CoAuToSe/Robocup-SSL-Aquitaine/SSL Senior (Small Size League)/Robot_SSL_v1_NAMeC/Electronique/brushless/brushless_parts.xlsx

Farnell | Name | Value | Device | Package | Link
721980 | C17 | 15pF | C_EU_22PF | C0603 | https://fr.farnell.com/yageo/cc0603jrnpo9bn150/cond-15pf-50v-5-c0g-np0-0603/dp/721980?ost=721980
 | C18 | 15pF | C_EU_22PF | C0603
1022248 | GND | CONNEC_1X03 | CONNEC_1X03 | CONNEC_1X03 | https://fr.farnell.com/harwin/m20-9990345/header-droit-2-54mm-1-rangee-3/dp/1022248?ost=1022248
 | V+ | CONNEC_1X03 | CONNEC_1X03 | CONNEC_1X03
1022256 | LOGIC | CONNEC_1X08 | CONNEC_1X08 | CONNEC_1X08 | https://fr.farnell.com/harwin/m20-9990845/embase-1-rangee-8-voies/dp/1022256?ost=1022256
1144713 | C10 | 100uF | CPOL_EU_3.5-8 | E3,5-8 | https://fr.farnell.com/rubycon/50zl100mefc8x11-5/condensateur-100-f-50v-20/dp/1144713?ost=1144713
1329624 | SENSE | ACS712 | ACS712 | SO8 | https://fr.farnell.com/allegro-microsystems/acs712elctr-20a-t/capteur-current-20a-soic8-712/dp/1329624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
1414620 | C20 | 18pF | CAP0805 | 0805@1 | https://fr.farnell.com/kemet/c0603c180j5gactu/cond-18pf-50v-5-c0g-np0-0603/dp/1414620?ost=1414620
 | C21 | 18pF | CAP0805 | 0805@1
1437637 | BUT | KMR211GLFS | BUTTON-KMR241GLFS | PUSHBUTTON-KMR241GLFS | https://fr.farnell.com/c-k-components/kmr241g-lfs/tactile-commutateur-cms-4n/dp/1437637?ost=1437637
 | RESET | KMR211GLFS | BUTTON-KMR241GLFS | PUSHBUTTON-KMR241GLFS
1581233 | D4 | Blue | LED1206 | LED-1206 | https://fr.farnell.com/multicomp/mcl-s250sblc/led-cms-1206-super-bleu/dp/1581233?ost=1581233
1606327 | UC1 | STM32F103CBT6 | STM32F103CB | LQFP48 | https://fr.farnell.com/stmicroelectronics/stm32f103cbt6/mcu-32bit-cortex-m3-72mhz-lqfp/dp/1606327?ost=1606327
1842013 | OSC1 | 40Mhz | CRYSTAL5X3 | CRYSTAL-SMD-5X3 | https://fr.farnell.com/txc/7b-40-000meeq-t/xtal-40-000mhz-10pf-smd-5-0x3/dp/1842013?ost=1842013
2296000 | DRV1 | OPEN-BLDC_IR2101 | OPEN-BLDC_IR2101 | OPEN-BLDC_SO-8 | https://fr.farnell.com/infineon/ir2101strpbf/driver-de-mosfet-high-low-side/dp/2296000?ost=2296000
 | DRV2 | OPEN-BLDC_IR2101 | OPEN-BLDC_IR2101 | OPEN-BLDC_SO-8
 | DRV3 | OPEN-BLDC_IR2101 | OPEN-BLDC_IR2101 | OPEN-BLDC_SO-8
2317446 | D1 | (empty) | ZETEX_VAR2SOT23 | ZETEX_SOT-23 | https://fr.farnell.com/on-semiconductor/bas21lt3g/diode-faible-signal-250v-sot-23/dp/2317446?ost=2317446
 | D2 | (empty) | ZETEX_VAR2SOT23 | ZETEX_SOT-23
 | D3 | (empty) | ZETEX_VAR2SOT23 | ZETEX_SOT-23
2319916 | Q1 | BUK7Y12-40E | BUK7Y12-40E | SOT669 | https://fr.farnell.com/nexperia/buk7y12-40ex/mosfet-n-ch-40v-52a-lfpak/dp/2319916?ost=2319916
 | Q2 | BUK7Y12-40E | BUK7Y12-40E | SOT669
 | Q3 | BUK7Y12-40E | BUK7Y12-40E | SOT669
 | Q4 | BUK7Y12-40E | BUK7Y12-40E | SOT669
 | Q5 | BUK7Y12-40E | BUK7Y12-40E | SOT669
 | Q6 | BUK7Y12-40E | BUK7Y12-40E | SOT669
2446904 | R1 | 1K | RESISTOR0805 | 805 | https://fr.farnell.com/multicomp/mcwr08x1001ftl/res-couche-epaisse-1k-1-0-125w/dp/2446904?st=2446904
 | R2 | 1K | RESISTOR0805 | 805
 | R3 | 1K | RESISTOR0805 | 805
 | R36 | 1K | RESISTOR0805 | 805
 | R39 | 1K | RESISTOR0805 | 805
 | R4 | 1K | RESISTOR0805 | 805
 | R49 | 1K | RESISTOR0805 | 805
 | R5 | 1K | RESISTOR0805 | 805
 | R6 | 1K | RESISTOR0805 | 805
2446909 | R28 | 1.5K | RESISTOR0805 | 805 | https://fr.farnell.com/multicomp/mcwr08x1501ftl/res-couche-epaisse-1-5k-1-0-125w/dp/2446909?st=2446909
2446926 | R29 | 22 | RESISTOR0805 | 805 | https://fr.farnell.com/multicomp/mcwr08x22r0ftl/res-couche-epaisse-22r-1-0-125w/dp/2446926?st=2446926
 | R35 | 22 | RESISTOR0805 | 805
2446939 | R20 | 2K | RESISTOR0805 | 805 | https://fr.farnell.com/multicomp/mcwr08x2001ftl/res-couche-epaisse-2k-1-0-125w/dp/2446939?st=2446939
2446965 | R21 | 3K | RESISTOR0805 | 805 | https://fr.farnell.com/multicomp/mcwr08x3001ftl/res-couche-epaisse-3k-1-0-125w/dp/2446965?st=2446965
2447553 | R10 | 10K | RESISTOR0805 | 805 | https://fr.farnell.com/multicomp/mcwr08x1002ftl/res-couche-epaisse-10k-1-0-125w/dp/2447553?ost=2447553
 | R11 | 10K | RESISTOR0805 | 805
 | R12 | 10K | RESISTOR0805 | 805
 | R14 | 10K | RESISTOR0805 | 805
 | R15 | 10K | RESISTOR0805 | 805
 | R16 | 10K | RESISTOR0805 | 805
 | R17 | 10K | RESISTOR0805 | 805
 | R18 | 10K | RESISTOR0805 | 805
 | R19 | 10K | RESISTOR0805 | 805
 | R23 | 10K | RESISTOR0805 | 805
 | R24 | 10K | RESISTOR0805 | 805
 | R25 | 10K | RESISTOR0805 | 805
 | R40 | 10K | RESISTOR0805 | 805
 | R48 | 10K | RESISTOR0805 | 805
 | R50 | 10K | RESISTOR0805 | 805
 | R7 | 10K | RESISTOR0805 | 805
 | R8 | 10K | RESISTOR0805 | 805
 | R9 | 10K | RESISTOR0805 | 805
2467818 | OSC | 8MHz | CRYSTAL5X3 | CRYSTAL-SMD-5X3 | https://fr.farnell.com/abracon/abm3b-8-000mhz-b2-t/crystal-8mhz-18pf-5-x-3-2mm/dp/2467818?ost=2467818
2470830 | K1 | (empty) | 614105150721 | 614105150721 | https://fr.farnell.com/wurth-elektronik/614105150721/embase-micro-usb-2-0-type-b-traversant/dp/2470830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
2496935 | C4 | 1000pF | CAP0805 | 0805@1 | https://fr.farnell.com/walsin/0805b102k500ct/cond-1000pf-50v-10-x7r-0805/dp/2496935?ost=2496935
2496946 | C12 | 1uF | CAP0805 | 0805@1 | https://fr.farnell.com/walsin/0805b105k160ct/condensateur-1-f-16v-10-x7r-0805/dp/2496946?ost=2496946
 | C7 | 1uF | CAP0805 | 0805@1
2528772 | C1 | 10µF | 0.33UF/330NF-0805-50V-10% | 805 | https://fr.farnell.com/tdk/c2012x5r1v106k085ac/condensateur-10-f-35v-10-x5r-0805/dp/2528772?ost=2528772
 | C2 | 10µF | 0.33UF/330NF-0805-50V-10% | 805
 | C3 | 10µF | 0.33UF/330NF-0805-50V-10% | 805
7261403 | REG1 | TS2940CW-3.3RP | TS2940CW-3.3RP | SOT223 | https://fr.farnell.com/taiwan-semiconductor/ts2940cw-3-3-rp/regulateur-cms-3-3v/dp/7261403?ost=7261403
- | ENC1 | LS7366RSO14 | LS7366RSO14 | SO14
 | JP1 | JUMPER-SMT_2_NO_NO-SILK_ROUND | JUMPER-SMT_2_NO_NO-SILK_ROUND | SMT-JUMPER_2_NO_NO-SILK_ROUND
 | JP2 | JUMPER-SMT_2_NO_NO-SILK_ROUND | JUMPER-SMT_2_NO_NO-SILK_ROUND | SMT-JUMPER_2_NO_NO-SILK_ROUND
 | X1 | JST-XH-10-PIN-LONG-PAD | JST-XH-10-PIN-LONG-PAD | JST-XH-10-PACKAGE-LONG-PAD
8737843RL | D5 | (empty) | DIODESOD | SOD-323 | https://fr.farnell.com/nexperia/pmeg2005aea-115/diode-schottky-boitier-sod-323/dp/8737843RL?ost=8737843rl
Total Result
 |  | jumper : cavalier
 |  | s
 |  | attention soudure : composants pas tous traversants : CMS (il faut obligatoirement une station à air chaud)
 |  | achat poste à air chaud
