CoAuToSe/Robocup-SSL-Aquitaine/SSL Senior (Small Size League)/Robot_SSL_v1_NAMeC/Electronique/kicker/kicker_parts.xlsx

Farnell | Name | Value | Device | Package | Links
1738824 | R5 | 10 | RESISTANCE-R0805 | R0805 | https://fr.farnell.com/vishay/crcw040210r0fkedhp/res-10r-1-0-2w-0402-couche-epaisse/dp/1738824?st=cms%2010ohm
 | R6 | 10 | RESISTANCE-R0805 | R0805
1469932 | R1 | 470 | RESISTANCE-R0805 | R0805 | https://fr.farnell.com/vishay/crcw0805470rfkea/res-couche-epaisse-470r-1-0-125w/dp/1469932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
 | R2 | 470 | RESISTANCE-R0805 | R0805
 | R4 | 470 | RESISTANCE-R0805 | R0805
 | R7 | 470 | RESISTANCE-R0805 | R0805
1738877 | R10 | 100K | RESISTANCE-R0805 | R0805 | https://fr.farnell.com/vishay/crcw0402100kfkedhp/res-100k-1-0-2w-0402-couche-epaisse/dp/1738877?st=100k%20cms
 | R11 | 100K | RESISTANCE-R0805 | R0805
 | R8 | 100K | RESISTANCE-R0805 | R0805
2447553 | R9 | 10K | RESISTANCE-R0805 | R0805 | https://fr.farnell.com/multicomp/mcwr08x1002ftl/res-couche-epaisse-10k-1-0-125w/dp/2447553?ost=2447553
 | R35 | 10K | RESISTANCE-R0805 | R0805
2319144 | D5 | 12V | ZENER-DIODESOD80C | SOD80C | https://fr.farnell.com/nexperia/bzv55-b12-115/diode-zener-12v-500mw-sod-80c/dp/2319144?ost=2319144
1469746 | R3 | 1M | RESISTANCE-R0805 | R0805 | https://fr.farnell.com/vishay/crcw06031m00fkea/res-couche-epaisse-1m-1-0-1w-0603/dp/1469746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
 | R34 | 1M | RESISTANCE-R0805 | R0805
9551735 | D2 | 1N6267A | 1N6267A | C4111-15 | https://fr.farnell.com/vishay/uf5408-e3-54/diode-de-redressement-rapide-3a/dp/9551735?ost=9551735
 | D3 | 1N6267A | 1N6267A | C4111-15
1637035RL | C1 | 1uF | C-EUC0805 | C0805 | https://fr.farnell.com/kemet/c0805c105k3ractu/condensateur-1-f-25v-10-x7r-0805/dp/1637035RL?st=c0805%201u
 | C2 | 1uF | C-EUC0805 | C0805
1097198 | D1 | 3.9V | ZENER-DIODESOD80C | SOD80C | https://fr.farnell.com/nexperia/bzv55-c3v9-115/diode-zener-500mw-3-9v/dp/1097198?ost=1097198
2446965 | R36 | 3K | RESISTANCE-R0805 | R0805 | https://fr.farnell.com/multicomp/mcwr08x3001ftl/res-couche-epaisse-3k-1-0-125w/dp/2446965?st=2446965
- | U$5 | BOOSTER | BOOSTER | BOOSTER_390V | https://fr.banggood.com/DC-DC-45-390V-Adjustable-High-Voltage-Booster-Regulator-Capacitor-Charging-Electromagnetic-Power-Module-p-1598959.html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
2251951 | Q1 | BSS123 | BSS123 | SOT23 | https://fr.farnell.com/on-semiconductor/bss123/mosfet-n-ch-100v-170ma-sot-23/dp/2251951?st=bss123
 | Q2 | BSS123 | BSS123 | SOT23
- | BOOST_EN | CONNEC_1X01 | CONNEC_1X01 | CONNEC_1X01 | -
 | POWERCAP1 | CONNEC_1X02BIG | CONNEC_1X02BIG | CONNEC_1X02_BIG | -
 | POWERCAP2 | CONNEC_1X02BIG | CONNEC_1X02BIG | CONNEC_1X02_BIG
- | SOLENOID1 | CONNEC_1X02BIG | CONNEC_1X02BIG | CONNEC_1X02_BIG | -
 | SOLENOID2 | CONNEC_1X02BIG | CONNEC_1X02BIG | CONNEC_1X02_BIG
1516283 | X2 | JST-XH-07-PIN-LONG-PAD | JST-XH-07-PIN-LONG-PAD | JST-XH-07-PACKAGE-LONG-PAD | https://fr.farnell.com/jst-japan-solderless-terminals/b7b-xh-a-lf-sn/embase-male-vertical-7-voies/dp/1516283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
1081223 | U$15 | NPN_BC817 | 215 | NPN_BC817 | https://fr.farnell.com/nexperia/bc817-215/transistor-npn-boitier-sot-23/dp/1081223?ost=1081223
8638730 | DRV1 | OPEN-BLDC_IR2101 | OPEN-BLDC_IR2101 | OPEN-BLDC_SO-8 | https://fr.farnell.com/infineon/ir2103spbf/driver-de-mosfet-igbt-cms-demi/dp/8638730?ost=8638730
 | DRV2 | OPEN-BLDC_IR2101 | OPEN-BLDC_IR2101 | OPEN-BLDC_SO-8
1581229 | D4 | RED | LED1206 | LED-1206 | https://fr.farnell.com/multicomp/mcl-s250src/led-cms-1206-super-rouge/dp/1581229?st=led1206
2610670 | U$1 | TO-247A | TO-247A | TO-247 | https://fr.farnell.com/on-semiconductor/fgh12040wd-f155/igbt-simple-canal-n-1-2kv-80a/dp/2610670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
 | U$11 | TO-247A | TO-247A | TO-247
