CoAuToSe/Robocup-SSL-Aquitaine/SSL Senior (Small Size League)/X-Proto 1/Liste_Banc_de_Test.xlsx

Liste Matériel
Nom de la piece | Utilité | Quantité dans l'article | Nombre à acheter | Prix Unitaire (€) | Prix Total (€) | Liens achat | Images
Roulement à bille (diamètre intérieur 3mm, extérieur 10mm) | Maintenir la barre du dribbleur durant le test | 1 | 2 | 3.61 | 7.22 | https://fr.rs-online.com/web/p/roulements-a-billes/8937420/
Cadre bois | Diminuer les vibrations | 1 | 0 | 13.5 | 0 | https://www.leroymerlin.fr/v3/p/produits/lot-de-6-tasseaux-sapin-petits-noeuds-brut-25-x-38-mm-l-2-4-m-e62031
Planche en bois | Soutenir le banc de test | 1 | 1 | 17.9 | 17.9 | https://www.leroymerlin.fr/produits/menuiserie/panneau-bois-tablette-etagere-tasseau-moulure-et-plinthe/panneau-bois-agglomere-mdf/panneau-bois-predecoupe/pre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
Scotch-Mousse | Diminuer les vibrations entre le banc de test et le Bati | 1 | 1 | 5.39 | 5.39 | https://fr.rs-online.com/web/p/rubans-mousse/0554866/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
Coupleur d'arbre d'accouplement (arbre 3mm de diamètre) | Coupler la dremmel et le dribbleur sans frottement | 1 | 1 | 44.52 | 44.52 | https://fr.rs-online.com/web/p/accouplements/0814556/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
 |  |  |  | Total (€) | 75.03
