CoAuToSe/Robocup-SSL-Aquitaine/SSL Senior (Small Size League)/Robot_SSL_v2/Liste_budget_SSLv2.xlsx

Sheet: Usinage
Composants à usiner
Nom | Nouveau nom | Description | Méthode d'usinage | Matériaux | Quantité | Commentaires | Images
01_Grundplatte | 01_Base plate | Plaque du bas | Milling | 7075 Aluminium Hight-Stength | 1
Mittleplatte | 02_Middle plate | Plaque Milieu | Milling | 7075 Aluminium Hight-Stength | 1
10_Lagerbock | 10_Motor leg | Socle moteur base | Milling | 7075 Aluminium Hight-Stength | 4
11_Radadapteur | 11_Wheel adapter | Adaptateur socle moteur roue | Milling | 7075 Aluminium Hight-Stength | 4
12_Radkasten | 12_Wheel inner | Roue intérieure | Milling | 7075 Aluminium Hight-Stength | 4
13_Raddeckel | 13_Wheel outher | Roue extérieure | Milling | 7075 Aluminium Hight-Stength | 4
14_Rolle | 14_Subwheel | Adaptateur roulement/X-Ring subwheels | Tournage | 7075 Aluminium Hight-Stength | 80
20_Dribbler Lagerbock | 20_Dribbler leg | Maintien rampe lob | Milling | 7075 Aluminium Hight-Stength | 2
21_Dribbler Seite | 21_Dribbler side | Coté dribbler | Milling | 7075 Aluminium Hight-Stength | 2
22_Dribbler Brueke | 22_Dribbler bridge | Plaque haut dribbler | Milling | 7075 Aluminium Hight-Stength | 1
23_Chip Schaufel | 23_Lob shovel | Rampe lob | Milling | 7075 Aluminium Hight-Stength | 1
24_Dribblingwelle | 24_Dribbling wheel | Axe dribbler | Tournage | 7075 Aluminium Hight-Stength | 1
25_Motorhalter | 25_Motor mount | Socle moteur dribbler | Milling | 7075 Aluminium Hight-Stength | 1
30_Kicker Eisen | 30_Kicker back | Partie Arrière des kickers | Milling | Ferromagnetic steel: St37 or C45 low carbon steel | 2
31_Kicker Sichel | 31_Kicker straight | Kicker droit partie avant | Milling | 7075 Aluminium Hight-Stength | 1
32_Kicker Chip | 32_Kicker lob | Kicker rampe-lob partie avant | Milling | 7075 Aluminium Hight-Stength | 1
33_Spulenhalter Hinten | 33_Spool holder at the back | Maintien arrière du kicker | Milling | 7075 Aluminium Hight-Stength | 1
34_Spulenhalter Vorne | 34_Spool holder in front | Maintien avant du kicker | Milling | 7075 Aluminium Hight-Stength | 1
35_maintien carte kicker | 35_maintien carte kicker | Maintien carte kicker | Milling | 7075 Aluminium Hight-Stength | 1

Sheet: Elec
Composants Electroniques
Nom / Référence | Description | Quantité | Spare (remplacement) | Commentaires | Prix Unitaire (€) | Prix total (€) | Liens achat | Images
Condensateur | Condensateurs cylindriques latéraux | 2 | 2 | 2200 µF - 200 V | 8.46 € | 33.84 € | https://uk.farnell.com/rubycon/200usg2200mefcsn35x40/cap-2200-f-200v-alu-elec-snap/dp/2102441 |  | 1800F-250V
4SLiPo | Batterie | 1 | 1 | 1800mAh Lipo - 22,2V | 30.86€ | 61.72 € | https://hobbyking.com/fr_fr/zippy-compact-1800mah-6s-40c-lipo-pack.html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
Maxon_EC45_70W | Moteur | 4 | 0 | Maxon_EC45_70W - 48V | 138.09€ | 552.36 € | https://www.maxongroup.fr/maxon/view/product/motor/ecmotor/ecflat/ecflat45/651620
MaxonECmax22-25W | Moteur dribbleur | 1 | 0 | MaxonECmax22-25W | 194.09 € | 194.09 € | https://www.maxongroup.fr/maxon/view/product/283856
Carte Mapple Mini simple | Cate servant à la programmation de tout le système embarqué | 1 | 3 |  | 6.90 € | 27.60 € | https://www.generationrobots.com/fr/403201-maple-mini.html
Kit Arduino (mapple mini) |  | 4 | 0 |  |  | 0.00 €
Module radio + Antennes radio 2.4GHz | 1100 Mètres Longue Distance NRF24L01+PA+LNA | 3 | 1 |  | 5.85 € | 23.40 € | https://www.banggood.com/fr/Geekcreit-1100-Meter-Long-Distance-NRF24L01+PA+LNA-Wireless-Module-With-Antenna-Module-p-1057170.html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
LED infrarouge + phototransistor | Barrière IR | lot | 0
Module infrarouge évitement obstacles | IR infrarouge evitement d'obstacle | 2 | 0 |  | 4.86 € | 9.72 € | https://fr.shopping.rakuten.com/offer/buy/2552519347/ir-infrarouge-evitement-d-39-obstacle-capteur-module-pour-arduino-voiture-smart-robot-fils-reflechissant-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 |  | impossible d'ouvrir le lien sous excel
Câbles normaux 2A, 24V | Câbles normaux supportant : 24V et 2A | lot | 0 | 24V ; 2A
Testeur de tension de batterie 1S-8S Lipo |  | 1 | 0 |  | 2.10 € | 2.10 € | https://fr.aliexpress.com/item/4000222359680.html?src=google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
Bobine de Cuivre | Fil de cuivre | 1 | 0 | 1.20mm,30 m de longueur | 20.89 € | 20.89 € | https://www.conrad.fr/p/fil-de-cuivre-tru-components-151501230-1562138-exterieur-sans-vernis-isolant-120-mm-30-m-1562138
Bobine de Cuivre | Fil de cuivre | 1 | 0 | 165m, 0.63mm, 0.5kg | 23.56 € | 23.56 € | https://www.conrad.de/de/p/block-kupferlackdraht-aussen-durchmesser-inkl-isolierlack-0-63-mm-165-m-0-50-kg-605523.html
 |  |  |  |  | Total (€) | 647.92 €

Sheet: Visserie
Composants Visserie
Nom / Référence | Quantité nécessaire | Description | Commentaires | Quantité dans l'article | Nombre à acheter (1 robot) | Prix Unitaire (€) | Prix Total (€) | Fournisseur liste Originale |  | Images
 |  |  |  |  |  |  |  | Fournisseur | N° Article
ISO 4762 - M2 x 6 | 15 | vis tete cylindrique M2 x 6 | ISO 4762 => DIN 912 | 50 | 1 | 2.74€ | 2.74€ | https://www.wegertseder.com/ArticleDetails.aspx?ANR=2534-234 | 2534-234
DIN 7984 - M3 x 5 | 32 | vis tete cylindrique M3 x 5 |  | 100 | 1 | 3.27€ | 3.27€ | https://www.wegertseder.com/ArticleDetails.aspx?ANR=2594-928 | 2594-928
DIN 7984 - M4 x 6 | 14 | vis tete cylindrique M4 x 6 |  | 50 | 1 | 2.99€ | 2.99€ | https://www.wegertseder.com/ArticleDetails.aspx?ANR=2594-954 | 2594-954
ISO 10642 - M3 x 6 | 22 | vis tete fraisée M3 x 6 |  | 100 | 1 | 3.24€ | 3.24€ | https://www.wegertseder.com/ArticleDetails.aspx?ANR=2608-680 | 2608-680
ISO 10642 - M3 x 8 | 34 | vis tete fraisée M3 x 8 |  | 100 | 1 | 3.28€ | 3.28€ | https://www.wegertseder.com/ArticleDetails.aspx?ANR=2608-682 | 2608-682
ISO 10642 - M4 x 8 | 8 | vis tete fraisée M4 x 8 |  | 100 | 1 | 3.47€ | 3.47€ | https://www.wegertseder.com/ArticleDetails.aspx?ANR=2608-708 | 2608-708
DIN 934 - M8 | 4 | Ecrou M8 |  | 10 | 1 | 2.61€ | 2.61€ | https://www.wegertseder.com/ArticleDetails.aspx?ANR=2914-422 | 2914-422
DIN 562 M3 | 4 | ecrou carré m3 |  | 100 | 1 | 3.86€ | 3.86€ | https://www.wegertseder.com/ArticleDetails.aspx?ANR=3198-486 | 3198-486
ISO - 4035 - M3 - C | 4 | Ecrou plat M3 | chez bafa pas 4035 | 100 | 1 | 2.89€ | 2.89€ | https://www.wegertseder.com/ArticleDetails.aspx?ANR=2996-111 | 2996-111
ISO 10642 - M3 x 16 | 4 | vis tete fraisée M3 x 16 |  | 100 | 1 | 3.00€ | 3.00€ | https://www.wegertseder.com/ArticleDetails.aspx?ANR=2608-690 | 2608-690
DIN 137 B8 | 4 | rondelle B 8mm |  | 100 | 1 | 4.16€ | 4.16€ | https://www.wegertseder.com/ArticleDetails.aspx?ANR=1738-294 | 1738-294
ISO 2338 - 2 m6 x 4 | 10 | Axe cylindrique 2mm x 4 |  | 200 | 1 | 5.38€ | 5.38€ | https://www.wegertseder.com/ArticleDetails.aspx?ANR=4347-136 | 4347-136
ISO 2338 - 2 m6 x 6 | 80 | Axe cylindrique 2mm x 6 | Forme pas totalement indentique | 200 | 1 | 5.09€ | 5.09€ | https://www.wegertseder.com/ArticleDetails.aspx?ANR=4347-140 | 4347-140
ISO 2338 - 2 m6 x 16 | 1 | Axe cylindrique 2mm x 16 | Forme pas totalement indentique | 200 | 1 | 7.50€ | 7.50€ | https://www.wegertseder.com/ArticleDetails.aspx?ANR=4347-150 | 4347-150
ISO 8745 4 x 10 | 4 | Goupille 4x10 |  | 20 | 1 | 6.35€ | 6.35€ | https://www.wegertseder.com/ArticleDetails.aspx?ANR=1028-042 | 1028-042
THERMAL PAD, 25.4X25.4MM, 1MM | 2 | Pad thermique |  | 1 | 2 | 3.31€ | 6.62€ | https://fr.farnell.com/wakefield-solutions/pl-1-5-254-h/thermal-pad-25-4x25-4mm-1mm/dp/2902536 | PL-1-5-254
Charge Marker | 1 | Indicateur batterie |  | 1 | 1 | 1.55€ | 1.55€ | https://www.stefansliposhop.de/en/accessories/charge-marker/charge-marker::1437.html | C-Marker
roullement 685-ZZ-C3 | 2 | Roulements à billes, disques de couverture des deux côtés, ID=5, AD=11, b=5 |  | 1 | 4 | 1.24€ | 4.96€ | https://www.kugellager-express.de/miniature-deep-groove-ball-bearing-685-zz-c3-5x11x5-mm | 685-ZZ-C3
roullement 692-ZZ | 2 | Roulements à billes, disques de couverture des deux côtés, ID=2, AD=6, b=3 |  | 1 | 4 | 2.40€ | 9.60€ | https://www.kugellager-express.de/stainless-steel-miniature-deep-groove-ball-bearing-ss-692-zz-2x6x3-mm | 692-ZZ
engrenage z20 | 1 | Roues en dents de front, laiton, module 0.5, z=20 (moteur) |  | 1 | 1 | 0 | 0 | https://www.michaud-chailly.fr/index.php?ent_id=1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 | 21102000
engrenage z20 | 1 | Roue en dents de front, laiton, module 0.5, z=20 | (axe l’engrenage est réusiné élargissement du trou) | 1 | 1 | 0 | 0 | https://www.michaud-chailly.fr/index.php?ent_id=1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 | 26102000
engrenage Polyketon z20 | 1 | Roue de l’extrémité, polycétone, module 0.5, z=20 |  | 1 | 1 | ? | #VALUE! | https://www.michaud-chailly.fr/index.php?ent_id=1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 | 28102001
X-Ring, 5.94x3.53 | 80 | X-Ring, 5.94x3.53mm, NBR, Shore A 70 |  | 1 | 85 | 0.18€ | 15.30€ | https://www.ir-dichtungstechnik.de/gewerbe/de/x-ring-5-94-x-3-53-mm-bs202-nbr-70-5-shore-a-schwarz-black.html | XRINGBS202NBR70
roulement MSM-0205-02 | 160 | Bague anti-frixtion MSM-0205-02 |  | 1 | 165 | 2.49€ | 410.85€ | https://www.igus.de/search?q=JSM-1012-05 | JSM-1012-05
ressort Z-015LI | 4 | Ressort de traction Z-015LI, Kickers |  | 1 | 5 | 2.77€ | 13.85€ | https://www.ferroflex.fr/fr/produits/ressorts_de_traction/z-015li.html | Z-015LI
ressort RZ-006DI | 2 | Ressort de traction RZ-006DI,Lober shovel |  | 1 | 3 | 2.83€ | 8.49€ | https://www.ferroflex.fr/fr/produits/ressorts_de_traction/rz-006di.html | RZ-006DI
Entretoise M4x60 | 4 | Entretoise Typ A, M4, 60mm |  | 100 | 1 | 38.10€ | 38.10€ | https://www.ettinger.de/p/kunststoff-abstandsbolzen-typ-a-i/i-m4/sw8x60-0-pa-gv-schwarz/005.30.460 | 5.30.460
Entretoise M4x70 | 3 | Entretoise Typ A, M4, 70mm |  | 100 | 1 | 34.20€ | 34.20€ | https://www.ettinger.de/p/abstandsbolzen-m3-typ-a/innen-innengewinde/005.03.701 | 005.03.701
Entretoise M3x63 | 5 | Entretoise Typ A, M3, 63mm |  | 100 | 1 | 39.60€ | 39.60€ | https://www.ettinger.de/p/kunststoff-abstandsbolzen-typ-a-i/i-m3/sw6x63-0-pa-gv-schwarz/005.30.363 | 005.30.363
Entretoise M3x25 | 12 | Entretoise Typ B, M3, 25mm |  | 100 | 1 | 24.50€ | 24.50€ | https://www.ettinger.de/p/kunststoff-abstandsbolzen-typ-b-i/a-m3x25-0-sw-6-pa-66-schwarz/005.43.250 | 005.43.250
Entretoise M3x25 | 4 | Entretoise Typ A, M3, 25mm |  | 100 | 1 | 27.40€ | 27.40€ | https://www.ettinger.de/p/kunststoff-abstandsbolzen-typ-a-i/i-m3/sw6x25-0-pa-gv-schwarz/005.30.325 | 005.30.325
Loctite | 1 | colle pour securiser le vis (egalement pr fixxer l'adaptateur roue / moteur au moteur) |  | 1 | 1 | 27.40€ | 27.40€ | https://de.rs-online.com/web/p/schraubensicherung-und-gewindesicherungsmittel/4767870/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 | 476-7870
Loctite 648 | 1 | colle pour securiser le vis (egalement pr fixxer l'adaptateur roue / moteur au moteur) |  | 1 | 1 | 59.28€ | 59.28€ | https://de.rs-online.com/web/p/sicherungsmittel/3731498/?searchHistory=%7B%22enabled%22%3Atrue%7D | 373-1498
 |  |  |  |  |  | Total | 781.53€

Sheet: Visserie BAFA
Composants Visserie
Nom / Référence | Quantité nécessaire | Description | Commentaires | Quantité dans l'article | Nombre à acheter (1 robot) | Prix Unitaire (€) | Prix Total (€) | Nouveaux Fournisseur (avec BAFA) |  | Images
 |  |  |  |  |  |  |  | Fournisseur | N° Article
ISO 4762 - M2 x 6 | 15 | vis tete cylindrique M2 x 6 | ISO 4762 => DIN 912 | 1 | 15 | 0.14€ | 2.10€ | https://shop.bafa-sa.com/vis-chc-din-912-m2x6-inox-a2-chi02006-15039.html | CHI02006
DIN 7984 - M3 x 5 | 32 | vis tete cylindrique M3 x 5 | Pas en x5 chez bafa donc en x6 | 1 | 34 | 0.14€ | 4.76€ | https://shop.bafa-sa.com/vis-chc-tete-basse-din-7984-m3x6-inox-a2-7984i03006-6755.html | 7984I03006
DIN 7984 - M4 x 6 | 14 | vis tete cylindrique M4 x 6 | non disponible chez bafa | 50 | 1 | 2.99€ | 2.99€ | https://www.wegertseder.com/ArticleDetails.aspx?ANR=2594-954 | 2594-954
ISO 10642 - M3 x 6 | 22 | vis tete fraisée M3 x 6 |  | 1 | 25 | 0.07€ | 1.75€ | https://shop.bafa-sa.com/vis-fhc-din-7991-m3x6-inox-a2-fhi03006-19906.html | FHI03006
ISO 10642 - M3 x 8 | 34 | vis tete fraisée M3 x 8 |  | 1 | 35 | 0.07€ | 2.45€ | https://shop.bafa-sa.com/vis-fhc-din-7991-m3x8-inox-a2-fhi03008-19907.html | FHI03008
ISO 10642 - M4 x 8 | 8 | vis tete fraisée M4 x 8 |  | 1 | 10 | 0.08€ | 0.80€ | https://shop.bafa-sa.com/vis-fhc-din-7991-m4x8-inox-a2-fhi04008-19918.html | FHI04008
DIN 934 - M8 | 4 | Ecrou M8 |  | 1 | 5 | 0.29€ | 1.45€ | https://shop.bafa-sa.com/ecrou-hu-din-934-m8-inox-a4-huy8-23879.html | HUY8
DIN 562 M3 | 4 | ecrou carré m3 |  | 1 | 5 | 0.05€ | 0.25€ | https://shop.bafa-sa.com/ecrous-carre-m3-inox-a2-562i3-5544.html | 562I3
ISO - 4035 - M3 - C | 4 | Ecrou plat M3 | chez bafa pas 4035 | 1 | 5 | 0.05€ | 0.25€ | https://shop.bafa-sa.com/ecrou-bas-hm-din-439b-m3-inox-a2-hmi3-23359.html | HMI3
ISO 10642 - M3 x 16 | 4 | vis tete fraisée M3 x 16 |  | 1 | 5 | 0.11€ | 0.55€ | https://shop.bafa-sa.com/vis-fhc-din-7991-m3x16-inox-a2-fhi03016-19911.html | FHI03016
DIN 137 B8 | 4 | rondelle B 8mm |  | 100 | 1 | 4.16€ | 4.16€ | https://www.wegertseder.com/ArticleDetails.aspx?ANR=1738-294 | 1738-294
ISO 2338 - 2 m6 x 4 | 10 | Axe cylindrique 2mm x 4 | indisponible chez bafa | 200 | 1 | 5.38€ | 5.38€ | https://www.wegertseder.com/ArticleDetails.aspx?ANR=4347-136 | 4347-136
ISO 2338 - 2 m6 x 6 | 80 | Axe cylindrique 2mm x 6 | Forme pas totalement indentique chez bafa | 200 | 1 | 5.09€ | 5.09€ | https://www.wegertseder.com/ArticleDetails.aspx?ANR=4347-140 | 4347-140
ISO 2338 - 2 m6 x 16 | 1 | Axe cylindrique 2mm x 16 | Forme pas totalement indentique | 1 | 2 | 0.29€ | 0.58€ | https://shop.bafa-sa.com/goup-cylindrique-din-7-2x16-inox-gcyi02016-21976.html | GCYI02016
ISO 8745 4 x 10 | 4 | Goupille 4x10 | ci | 20 | 1 | 6.35€ | 6.35€ | https://www.wegertseder.com/ArticleDetails.aspx?ANR=1028-042 | 1028-042
THERMAL PAD, 25.4X25.4MM, 1MM | 2 | Pad thermique |  | 1 | 2 | 3.31€ | 6.62€ | https://fr.farnell.com/wakefield-solutions/pl-1-5-254-h/thermal-pad-25-4x25-4mm-1mm/dp/2902536 | PL-1-5-254-H
Charge Marker | 1 | Indicateur batterie |  | 1 | 1 | 1.55€ | 1.55€ | https://www.stefansliposhop.de/en/accessories/charge-marker/charge-marker::1437.html | C-Marker
roullement 685-ZZ-C3 | 2 | Roulements à billes, disques de couverture des deux côtés, ID=5, AD=11, b=5 |  | 1 | 4 | 1.24€ | 4.96€ | https://www.kugellager-express.de/miniature-deep-groove-ball-bearing-685-zz-c3-5x11x5-mm | 685-ZZ-C3
roullement 692-ZZ | 2 | Roulements à billes, disques de couverture des deux côtés, ID=2, AD=6, b=3 |  | 1 | 4 | 2.40€ | 9.60€ | https://www.kugellager-express.de/stainless-steel-miniature-deep-groove-ball-bearing-ss-692-zz-2x6x3-mm | 692-ZZ
engrenage z20 | 1 | Roues en dents de front, laiton, module 0.5, z=20 (moteur) |  | 1 | 1 |  | 0 | https://www.michaud-chailly.fr/index.php?ent_id=1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 | A1-26-20-1
engrenage z20 | 1 | Roue en dents de front, laiton, module 0.5, z=20 | (axe l’engrenage est réusiné élargissement du trou) | 1 | 1 |  | 0 | https://www.michaud-chailly.fr/index.php?ent_id=1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 | A1-263-20-1
engrenage Polyketon z20 | 1 | Roue de l’extrémité, polycétone, module 0.5, z=20 |  | 1 | 1 |  | 0 | https://www.michaud-chailly.fr/index.php?ent_id=1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 | A1-266-20-1
X-Ring, 5.94x3.53 | 80 | X-Ring, 5.94x3.53mm, NBR, Shore A 70 |  | 1 | 85 | 0.18€ | 15.30€ | https://www.ir-dichtungstechnik.de/gewerbe/de/x-ring-5-94-x-3-53-mm-bs202-nbr-70-5-shore-a-schwarz-black.html | XRINGBS202NBR70
roulement MSM-0205-02 | 160 | Bague anti-frixtion MSM-0205-02 |  | 1 | 165 | 2.49€ | 410.85€ | https://www.igus.de/search?q=JSM-1012-05 | JSM-1012-05
ressort Z-015LI | 4 | Ressort de traction Z-015LI, Kickers |  | 1 | 5 | 2.77€ | 13.85€ | https://www.ferroflex.fr/fr/produits/ressorts_de_traction/z-015li.html | Z-015LI
ressort RZ-006DI | 2 | Ressort de traction RZ-006DI,Lober shovel |  | 1 | 3 | 2.83€ | 8.49€ | https://www.ferroflex.fr/fr/produits/ressorts_de_traction/rz-006di.html | RZ-006DI
Entretoise M4x60 | 4 | Entretoise Typ A, M4, 60mm |  | 1 | 5 | 2.90€ | 14.50€ | https://shop.bafa-sa.com/entretoise-hexagonale-f-f-m4x60-laiton-nickele-ff04060-19525.html | FF04060
Entretoise M4x70 | 3 | Entretoise Typ A, M4, 70mm |  | 1 | 5 | 4.13€ | 20.65€ | https://shop.bafa-sa.com/entretoise-hexagonale-f-f-m4x70-laiton-nickele-ff04070-19526.html | FF04070
Entretoise M3x63 | 5 | Entretoise Typ A, M3, 63mm | Pas disponible chez bafa | 100 | 1 | 39.60€ | 39.60€ | https://www.ettinger.de/p/kunststoff-abstandsbolzen-typ-a-i/i-m3/sw6x63-0-pa-gv-schwarz/005.30.363 | 005.30.363
Entretoise M3x25 | 12 | Entretoise Typ B, M3, 25mm | pas disposnible en Plastique chez bafa | 100 | 1 | 24.50€ | 24.50€ | https://www.ettinger.de/p/kunststoff-abstandsbolzen-typ-b-i/a-m3x25-0-sw-6-pa-66-schwarz/005.43.250 | 005.43.250
Entretoise M3x25 | 4 | Entretoise Typ A, M3, 25mm | pas disposnible en Plastique chez bafa | 100 | 1 | 27.40€ | 27.40€ | https://www.ettinger.de/p/kunststoff-abstandsbolzen-typ-a-i/i-m3/sw6x25-0-pa-gv-schwarz/005.30.325 | 005.30.325
Loctite | 1 | colle pour securiser le vis (egalement pr fixxer l'adaptateur roue / moteur au moteur) |  | 1 | 1 | 27.40€ | 27.40€ | https://de.rs-online.com/web/p/schraubensicherung-und-gewindesicherungsmittel/4767870/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 | 476-7870
Loctite 648 | 1 | colle pour securiser le vis (egalement pr fixxer l'adaptateur roue / moteur au moteur) |  | 1 | 1 | 59.28€ | 59.28€ | de.rs-online.com | 373-1498

Sheet: Liste total usinage
Nombre de robots | 6 |  |  |  | Dimention de matière minimale (mm) |  |  | ± Masse de matière première (g)
Nom | Description | Méthode d'usinage | Option d'usinage (hauteur de couche) | Matériaux | x | y | z |  | Nbr. 1 Bot | Nbr. X Total | Méthodes d'usinage disponible | Matériaux cités
000_Maintien Condo | Maintien le condo | 3D Printing | 0,2mm | PLA |  |  |  |  | 2 | 12 | Milling | 7075 Hight-Stength Aluminium
000_motor board holder 1 | maintien cate mot gauche | 3D Printing | 0,2mm | PLA |  |  |  |  | 1 | 6 | Tournage | PETG
000_motorboard holder 2 | maintien cate mot droit | 3D Printing | 0,2mm | PLA |  |  |  |  | 1 | 6 | Moulage | Ferromagnetic steel: St37 or C45 low carbon steel
000_Carénage Manteau | Carrénage | 3D Printing | 0,3mm | PETG |  |  |  |  | 1 | 6 |  | TPU98
000_Carrénage Underplate | Plaque sous carrénage | 3D Printing | 0,2mm | PETG |  |  |  |  | 1 | 6 |  | Smooth-on vytaflex 30
000_Kickerdamper | Amorti ckicker fin course | 3D Printing | 0,2mm | TPU98 |  |  |  |  | 2 | 12
000_Spoolcore | Centre de la bobine | 3D Printing | 0,2mm | PLA |  |  |  |  | 2 | 12
001_Dribblerdamper | Amorti coup dribler (coup de la balle ds le dribbler) | Moulage |  | Smooth-on vytaflex 30 | 1637,29 mm3 |  |  |  | 1 | 6
001_Dribblerdamper Under | amorti dribler vibration dessous | Moulage |  | Smooth-on vytaflex 30 | 130 mm3 |  |  |  | 2 | 12
001_Dribblers rubber | Dribbler mou | Moulage |  | Smooth-on vytaflex 60 | 5525,23 mm3 |  |  |  | 1 | 6
01_Baseplate | Plaque du bas | Milling |  | 7075 Hight-Stength Aluminium | 176 | 164 | 3 |  | 1 | 6
02_Midleplate | Plaque Mid | Milling |  | 7075 Hight-Stength Aluminium | 174 | 162 | 2 |  | 1 | 6
10_Motor leg | socle moteur base | Milling |  | 7075 Hight-Stength Aluminium | 40 | 38 | 5 |  | 4 | 24
11_Wheel adapter | atapteur socle moteur roue | Milling |  | 7075 Hight-Stength Aluminium | 8,3 -0,05+0,00 | 8,3 -0,05+0,00 | 15 |  | 4 | 24
12_Wheel inner | Roue int | Milling |  | 7075 Hight-Stength Aluminium | 53 | 53 | 11.6 |  | 4 | 24
13_Wheel outer | Roue ext | Milling |  | 7075 Hight-Stength Aluminium | 53 | 53 | 5 |  | 4 | 24
14_Subwheel | adapteur roulement/X-Ring subwheels | Tournage |  | 7075 Hight-Stength Aluminium | Ø 9 ±0,1 |  | 4 ±0,1 |  | 80 | 480
20_Dribbler Leg | Maintien lober | Milling |  | 7075 Hight-Stength Aluminium | 26.5 | 20 | 6 |  | 2 | 12
21_Dribbler Side | Coté dribbler | Milling |  | 7075 Hight-Stength Aluminium | 47 | 31 | 5 |  | 2 | 12
22_Dribbler Bridge | Plaque haut dribbler | Milling |  | 7075 Hight-Stength Aluminium | 90 | 37 | 4 |  | 1 | 6
23_Lob shovel | lober | Milling |  | 7075 Hight-Stength Aluminium | 67 -0,1+0,0 | 15 | 24.5 |  | 1 | 6
24_Dribbling wheel | axe dribbler | Tournage |  | 7075 Hight-Stength Aluminium | Ø 6,5 ± 0,05 |  | 89.6 |  | 1 | 6
25_Motor mount | socle moteur dribbler | Milling |  | 7075 Hight-Stength Aluminium | 28 | 19.5 | 6 |  | 1 | 6
30_Kicker back | Partie Arrière des kickers | Milling |  | Ferromagnetic steel: St37 or C45 low carbon steel | 75 | 24 -0,1 +0,0 | 4 -0,1 +0,0 |  | 2 | 12
31_Kicker straight | Kicker droit partie avant | Milling |  | 7075 Hight-Stength Aluminium | 62 | 57 | 12 |  | 1 | 6
32_Kicker lob | Kicker lob partie avant | Milling |  | 7075 Hight-Stength Aluminium | 54 | 48 | 6.6 |  | 1 | 6
33_Spool holder at the back | Maintien arrière du kicker | Milling |  | 7075 Hight-Stength Aluminium | 42 | 38 | 6 |  | 1 | 6
34_Spool holder in front | Maintien avant du kicker | Milling |  | 7075 Hight-Stength Aluminium | 55 | 38 | 10 |  | 1 | 6
35_maintien carte kicker | maintien de la carte du kicker + heatsink | Milling |  | 7075 Hight-Stength Aluminium | 47.973 | 79.8 | 5
999_ Dribblerschnecke bas | Moulages | 3D Printing | 0,15mm | PLA |  |  |  | 11
999_ Dribblerschnecke haut | Moulages | 3D Printing | 0,15mm | PLA |  |  |  | 11.1
999_ Dribblerschnecke maintien axe | Moulages | 3D Printing | 0,15mm | PLA |  |  |  | 4.2
999_ Dribblerdaempfer Unten Bas | Moulages | 3D Printing | 0,15mm | PLA |  |  |  | 1.5
999_ Dribblerdaempfer Unten haut | Moulages | 3D Printing | 0,15mm | PLA |  |  |  | 1
999_ Dribblerdaempfer bas | Moulages | 3D Printing | 0,15mm | PLA |  |  |  | 6.5
999_ Dribblerdaempfer haut | Moulages | 3D Printing | 0,15mm | PLA |  |  |  | 2.3
