CoAuToSe/Robocup-SSL-Aquitaine/SSL Senior (Small Size League)/X-Proto 1/Liste X-Proto 1.xlsx

Liste X-Proto 1
Nom du composant | Numéro d'article | Utilité | Nb necessaire | Quantité dans l'article | Nombre à acheter | Prix Unitaire (€) | Prix Total (€) | Liens achat | Lien originel de référence | Images
Composants Electroniques
Driver Moteur |  | Controle/Alimentation moteur | 5 | 1 | 6 | 12.67€ | 76.02€ | https://fr.banggood.com/BLDC-Three-phase-DC-Brushless-Hallless-Motor-Controller-ESC-Motor-Driver-Board-High-Power-p-1544114.html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 |  |  | driver originel (version finale) https://fr.farnell.com/nanotec/smci12/controleur-moteur-24v-2-7a/dp/1962046?MER=sy-me-pd-mi-acce
Moteur 24V; 2,36A; 5260rpm |  | Faire tourner la roue | 5 | 1 | 5 | 51.54€ | 257.70€ | https://fr.farnell.com/nanotec/df45m024053-a2/moteur-bldc-24vdc-6700rpm/dp/2507572 |  |  | site nanotec originel : https://en.nanotec.com/products/1789-df45m024053-a2-brushless-dc-motor-with-connecting-wires
Microcontroleur Black Pill |  |  |  |  |  |  |  | https://fr.aliexpress.com/item/4001113377360.html
Batterie 22,2V |  | Alimenter le système | 1 | 1 | 0 | 30.61€ | 0.00€ | https://hobbyking.com/fr_fr/zippy-compact-1800mah-6s-40c-lipo-pack.html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
Connecteur batterie + chargeur |  | Charger la batterie | 1 | 1 | 0 |  | 0.00€
7805 To-220-3 |  | Prends un voltage compris entre 10 et 35V en entrée, sort 5V en sortie (et 2A) | 1 | 1 | 2 | 0.77€ | 1.55€ | https://fr.farnell.com/stmicroelectronics/l78s05cv/regulateur-5-0v-78s05-to-220-3/dp/9756086
Dissipateur Thermique TO220 |  | Dissipateur de chaleur du 7805 To-220-3 | 1 | 1 | 2 | 0.28€ | 0.56€ | https://fr.rs-online.com/web/p/dissipateurs-de-chaleur/3608764/
Fusible |  | Proteger le moteur de surintensités | 5 | 1 | 10 | 0.26€ | 2.60€ | https://fr.rs-online.com/web/p/fusibles-cartouches/9113470/ |  |  | https://fr.rs-online.com/web/p/fusibles-rearmables-ptc/5176843/
Visserie |  |  |  |  |  |  |  |  |  |  | vis-express.fr
Vis M3*8 (ISO 10642 M3 x 8) | PACK-SFB3-8 | Fixation roues | 28 | 1 | 30 | 0.14€ | 4.32€ | https://fr.rs-online.com/web/p/vis-a-six-pans/3044918/ | https://fr.misumi-ec.com/vona2/detail/110300241010/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 |  | https://www.vis-express.fr/fr/vmx-tf-torx-inox-a4-din-965/41953-993008-vis-metaux-tete-fraisee-torx-t10-3x8-inox-a4-3663072415881.html
Rondelle Elastique (DIN 137 B8) | MDS8-2 | Fixation roues (1/roue) utilité translission roue | 4 | 1 | 5 | 0.32€ | 1.60€ | https://www.vis-express.fr/fr/rondelle-onduflex-type-b-inox-a2/37034-732527-rondelle-onduflex-inox-a2-m25-type-b-din-137b-3663072397279.html | https://fr.misumi-ec.com/vona2/detail/221000530418/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 |  | https://www.vis-express.fr/fr/rondelle-onduflex-type-b-inox-a2/37034-732527-rondelle-onduflex-inox-a2-m25-type-b-din-137b-3663072397279.html
Ecrou M8 (DIN 934 M8) | 934A28 | Fixation roues (1/roue) utilité tenir la Roue) | 4 | 10 | 1 | 6.80€ | 6.80€ | https://www.amazon.fr/AERZETIX-Hexagonaux-Filetage-Aiguilles-Bricolage/dp/B08N3WML8Z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 | https://fr.misumi-ec.com/vona2/detail/221006347498/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 |  | https://www.vis-express.fr/fr/ecrou-hu-a2-din-934/191984-1498360-ecrou-hexagonal-hu-m8-inox-a2-noir-3663072227545.html
Axe 2*6mm (ISO 2338 2 m6 x 6) | HPB-2X6 | Fixation roues | 80 | 10 | 1 | 7.49€ | 7.49€ | https://www.amazon.fr/dp/B00H55UIL4 | https://fr.misumi-ec.com/vona2/detail/221000596803/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 |  | Pas aussi petit..
X-Ring 5,94 x 3,53 | XRINGBS202NBR70 | X-Ring | 80 | 1 | 80 | 0.18€ | 14.40€ | https://www.ir-dichtungstechnik.de/gewerbe/de/x-ring-5-94-x-3-53-mm-bs202-nbr-70-5-shore-a-schwarz-black.html
CHC M4 x 8 (6 pans creux tête cylindrique) (DIN 7984 M4x6) | CSHHC-SUS-M4-6 | Fixation roues (fixation block moteur) | 16 | 50 | 1 | 8.20€ | 8.20€ | https://www.amazon.fr/Aerzetix-boulons-cylindrique-DIN7984-empreinte/dp/B074M63MSW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 | https://fr.misumi-ec.com/vona2/detail/221005681814/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 |  | https://www.vis-express.fr/fr/vis-tole-chc-btr-inox-a2/50989-892455-vis-tole-chc-btr-inox-a2-48x45-3663072465640.html | https://www.amazon.fr/DIN7984-inoxydable-courte-Boulon-robustes/dp/B08P6WT5CZ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
FHC M4 x 8 (6 pans creux tête fraisée) (ISO 10642 M4x8) | SFB4-8 | Fixation roues(fixation block moteur) | 16 | 50 | 1 | 7.89€ | 7.89€ | https://www.amazon.fr/Boulons-Plate-Etoile-Acier-Inoxydable/dp/B073W7CC6J | https://fr.misumi-ec.com/vona2/detail/110300241010/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 |  | https://www.vis-express.fr/fr/vmx-tf-torx-inox-a4-din-965/41960-993040-vis-metaux-tete-fraisee-torx-t20-4x8-inox-a4-3663072415973.html
Entretoise (M4x60mm) Typ A M4 60mm SW8 |  | Fixation chassis | 4 | 10 | 1 | 17.99€ | 17.99€ | https://www.amazon.fr/Entretoise-dentretoise-m%C3%A2le-femelle-laiton-solide/dp/B08B66SL5V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 | https://shop.bafa-sa.com/entretoise-hexagonale-f-f-m4x60-laiton-nickele-ff04060-19525.html
Plaque plexy |  | Test plaques support découpe laser |  | 1 | 0 | 19.50€ | 0.00€ | https://www.leroymerlin.fr/produits/menuiserie/panneau-bois-tablette-etagere-tasseau-moulure-et-plinthe/verre-verre-synthetique-et-accessoires/verre-et-plaque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
Câbles (1A + 2A) |  | faire passer la puissance a travers les composant |  | 0 | 0 |  |  | Fab
 |  |  |  |  |  | Total (€) | 407.12€
 |  |  |  |  |  |  |  | Hugo : Amazon : 48,37€, bangood : 69,26€
 |  |  |  |  |  |  |  | Vis Express : Laetitia : 11,83€
 |  |  |  |  |  |  |  | Dichtungstechnik : Valentin : 18,20€
