CoAuToSe/Robocup-SSL-Aquitaine/SSL Senior (Small Size League)/X-Proto 1/Résumé Bloc Roue.xlsx

Nbr de Blocs: Roues | 4 |  | Usinage |  |  |  |  |  | Qte Total | Comentaires
Nom de la pièce | Description | Qte/bloc roue | Prototype |  | Finale
 |  |  | Méthode | Materiaux | Méthode | Materiaux
10_Motor leg | support d'atache du bloc moteur à la base | 1 | Impression 3D | PLA | Fraisage 3-axes | 7075 Hight-Stength Aluminium |  |  | 4
11_Wheel adapter | Adapteur axe moteur -> Roue | 1 | Impression 3D | PLA | Fraisage 3-axes | 7076 Hight-Stength Aluminium |  |  | 4 | filetage M8 à faire post usinage / Conseille d'utiliser de collets d'aeromodélisme pour le prototype
12_Wheel inner | Jante intérieure | 1 | Impression 3D | PLA | Fraisage 3-axes | 7077 Hight-Stength Aluminium |  |  | 4
13_Wheel outer | Jante extérieure | 1 | Impression 3D | PLA | Fraisage 3-axes | 7078 Hight-Stength Aluminium |  |  | 4
Roulement MSM-005-02 (https://www.igus.de/product/?artnr=JSM-0205-02) | Bague anti frixion | 40 | Impression 3D | ABS | ACHAT -> Ref liste achat |  |  |  | 160 | on peut réduire à 20/roues si on en fusione 2 par 2
14_Subwheel | Jante Roulette | 20 | Impression 3D | PLA / ABS | Tournage | 7078 Hight-Stength Aluminium |  |  | 80 | Conseille l'usinage métal, je ne pense pas que sa résiste aux éfforts
01_Baseplate | Base d'atache des blocs moteurs | 1 | Découpe laser | bois | Fraisage 3-axes | 7078 Hight-Stength Aluminium |  |  | 1 | ! Epaisseur 3mm
02_Middleplate | plaque supérieur pour attache autres composants | 1 | Découpe laser | bois | Fraisage 3-axes | 7079 Hight-Stength Aluminium |  |  | 1 | ! Epaisseur 3mm
 |  |  | ACHAT
Nom de la pièce | Description | Qte/bloc roue | Quantité dans l'article | Nombre à acheter (1 Bloc) | Prix Unitaire (€) | Fournisseur | N° Article | Prix Total pour (x blocs) | Qte Total | Comentaires
ISO 10642 M3 x 8 | FHC M3 x 8 (6 pans creux tête fraisée) | 7 | 100 | 1 | 15.51 € | fr.misumi-ec.com | PACK-SFB3-8 (https://fr.misumi-ec.com/vona2/detail/110300241010/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) | 15.51 € | 1
DIN 137 B8 | Rondelle élastique | 1 | 1 | 1 | 0.32 € | fr.misumi-ec.com | MDS8-2 (https://fr.misumi-ec.com/vona2/detail/221000530418/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) | 1.28 € | 4
Din 934 M8 | Ecrou M8 | 1 | 1 | 1 | 3.12 € | fr.misumi-ec.com | 934A28 (https://fr.misumi-ec.com/vona2/detail/221006347498/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) | 12.48 € | 4
ISO 2338 2 m6 x 6 | Axe 2mm x 6mm | 20 | 1 | 20 | 0.28 € | fr.misumi-ec.com | HPB-2X6 (https://fr.misumi-ec.com/vona2/detail/221000596803/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) | 22.40 € | 80
X-Ring 5,94 x 3,53 | X-Ring | 20 | 1 | 20 | 0.18 € | ir-dichtungstechnik.de/gewerbe/de/ | XRINGBS202NBR70 (https://www.ir-dichtungstechnik.de/gewerbe/de/x-ring-5-94-x-3-53-mm-bs202-nbr-70-5-shore-a-schwarz-black.html) | 14.40 € | 80
 |  |  |  |  |  |  |  | 0.00 €
DIN 7984 M4 x 6 | CHC M4 x 8 (6 pans creux tête cylindrique) | 4 | 1 | 4 | 0.07 € | fr.misumi-ec.com | CSHHC-SUS-M4-6 (https://fr.misumi-ec.com/vona2/detail/221005681814/) | 0.28 € | 4 | Pour fixer la carte supérieure
ISO 10642 M4 x 8 | FHC M4 x 8 (6 pans creux tête fraisée) | 4 | 1 | 4 | 0.57 € | fr.misumi-ec.com | SFB4-8 (https://fr.misumi-ec.com/vona2/detail/110300241010/) | 2.28 € | 4
Entretoise Typ A M4 60mm SW8 | antretoise M4 x 60mm | 1 | 100 | 1 | 38.10 € | ettinger.de | 005.30.460 (https://www.ettinger.de/p/kunststoff-abstandsbolzen-typ-a-i/i-m4/sw8x60-0-pa-gv-schwarz/005.30.460) | 38.10 € | 1
 |  |  |  |  |  |  |  | 0.00 €
Loctite 648 | Colle mécanique |  |  |  |  | fr.farnell.com/search?ost=loctite+648&searchref=searchlookahead&gamme-de-produit=loctite-648 |  | 0.00 € |  | sert à coller l'adaptaeur des roues à l'axe moteur (! Collage permanat)
Roulement MSM-005-02 | Bague anti frixion | 40 | 1 | 40 | 0.45 € | igus.de | JSM-0205-02 (https://www.igus.de/product/?artnr=JSM-0205-02) | 72.00 € | 160 | pas besoin d'acheter pour le prototype si fait en impression 3D (33,60€ pour 40) / possible manipulation pour remettre le diametre interieur (d1=2mm) / peut etre touvé ches misumi mais plus cher (même ref)
