CoAuToSe/Robocup-SSL-Aquitaine/SSL Senior (Small Size League)/Robot_SSL_v1_NAMeC/Mécanique/Liste matériel Résine.xlsx

Liste Matériel Résine
Nom / Référence | Quantité | Description | Type | Commentaires | Quantité dans l'article | Nombre à acheter | Prix Unitaire (€) | Prix Total (€) | Liens achat | Images
PU shore 60(250g) | 2 | Matière à mélanger pour faire le caoutchouc | MP | bien choisir 250 g en option d'achat | 1 | 2 | 15 | 30 | http://www.mouldcraft.co.uk/shop/4572905647/moudcraft-black-60-poly-pt-flex-60-fast-cure---shore-a60-polyurethane-casting-rubber/9724915
100 seringues(5ml) | 2 | Seringues pour injection dans les moules | Outils d'injection |  | 1 | 2 | 13.19 | 26.38 | https://www.amazon.fr/Romed-100-seringues-st%C3%A9riles-usage-unique/dp/B001NXG8L8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
Becher 25ml | 4 | Bécher pour contenir la réaction | verrerie |  | 2 | 2 | 16.99 | 33.98 | https://www.amazon.fr/Rocwing-B%C3%A9cher-Gradu%C3%A9-Borosilicate-Laboratoire/dp/B075Z3Y1V6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
Agitateur | 1 | Agitateur | Outils d'injection |  | 10 | 1 | 6.16 | 6.16 | https://www.amazon.fr/Romote-10-Cocktail-agitateurs-inoxydable-Touilleurs/dp/B07BCDZQC7?s=kitchen
Démoulant PU | 2 | Liquide pour démouler les injections | liquide |  | 1 | 2 | 20.85 | 41.7 | https://www.boutique.resines-et-moulages.com/demoulants/292-demoulant-liquide-pour-polyurethane.html
Gants nitrile | 1 | Gants de protection | équipement |  | 100 | 1 | 24.49 | 24.49 | https://www.amazon.fr/Nitrile-Hizek-jetable-Anti-allergiques-r%C3%A9sistants/dp/B0865J9SVC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
Lunette ? | 2 | Lunettes de protection | équipement |  | 1 | 2 | 9.99 | 19.98 | https://www.amazon.fr/Draeger-Protection-Lunettes-protection-Disque/dp/B076WNT3QW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
SSFRJ10-69-F15-H2-G5-P3-T15-Z2-V5-Q3-WKC15-C10-K15-E10:1 | 25 | axe dribbler diamettre 3mm, longueur 110mm | Axe |  | 1 | 15 | 1.21 | 18.15 | https://www.gotronic.fr/art-axe-en-acier-3x110mm-11812.htm
 |  |  |  |  |  |  | Total (€) | 200.84
