CoAuToSe/Robocup-SSL-Aquitaine/SSL Senior (Small Size League)/Commande_connecteurs.xlsx

Référence | Désignation | Prix | Lien
JST ZH 9 broches | Connecteur données moteur | 21.51€ | https://www.amazon.fr/IGOSAIT-connecteurs-broches-longueur-couleur/dp/B0951Z6YMW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
JST ZH 7 broches | Connecteur données kicker | 20.64€ | https://www.amazon.fr/IGOSAIT-connecteurs-broches-longueur-couleur/dp/B0951YXJ21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
JST ZH 4 broches | Connecteur données barrière IR | 9.99€ | https://www.amazon.fr/TuToy-Ensembles-Connecteurs-Broches-C%C3%A2bles/dp/B0834WC533
JST 2 broches | Connecteur puissance moteurs | 7.99€ | https://www.amazon.fr/TOOHUI-Pairs-Connecteur-Broches-C%C3%A2bles/dp/B07NY8CQRV?hvadid=330850709901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
Scratch | Tenir éléments (batterie...) | 9.99€ | https://www.amazon.fr/gp/aw/d/B091SW2B63/?aaxitk=78e30c1ba2acd86d076e0ada07299ef8&hsa_cr_id=3673722300802
 | Total | 70.12€
