CoAuToSe/Robocup-SSL-Aquitaine/SSL Senior (Small Size League)/Comparaison Entreprise Découpe CNC ALU.xlsx

Laser cutting |  |  | Antoine
Liste Entreprise CNC découpe
Entreprise | URL site | Avantage | Prix approx | Lieux d'origine | délais | Numéro de Téléphone | adresse mail
Xometry | https://xometry.eu/fr/usinage-cnc/ | devis instantanné en ligne |  | Munich/Germany | 3j (d'aprés site) | 33-1-76-35-12-17 49-89-3803-4818 | info@xometry.eu
Protolabs | https://www.protolabs.fr/services/usinage-cnc/ | Devis en ligne possible après inscription sur le site |  | Savoie-Technolac Parc Ouragan Bâtiment C Rue du Lac Majeur – BP 331 73377 Le Bourget du Lac Cedex France | Standard : 7j (gratuit) Economique : 15j Economique+ : 21j Economique++ : 28j Accéléré : 4-5j ( 67% +cher) | 33 (0)4 56 64 80 50 | customerservice@protolabs.fr
Acma | https://acma33.fr/fraisage-bordeaux-gironde | Région Bordelaise,devis en ligne possible et joignable pour plus de renseignement |  | Bordeaux | inconnue | 05 56 20 23 23 | contact@acma33.fr
Dassault Systèmes (Make) | https://make.3dexperience.3ds.com/welcome | Devis en ligne possible après inscription sur le site |  | 53 avenue de l'Europe 13090 Aix-en-Provence, France | Inconnue | X | Marketplace.Make@3ds.com
PCBway | https://www.pcbway.com/rapid-prototyping/manufacture/?campaignid=12599416707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 | peut chère (en théorie), Chinois,devis en ligne possible , possibilité de Sponsorship étudiant |  | Chine (usine à Schenzen) | 13-15 jours | 86 571 8531 7532 | fr-sales01@pcbway.com
Haizol | https://www.haizol.com/international/resources/CNC-OSS-V.html | devis en ligne instantannée , low cost (d'après site) |  | Amérique, californie,500 South Kraemer Blvd., Suite 205, Brea, California 92821 | quelques jours (d'après site) | 1-310-844-9041 | info@haizol.com
Premachining | https://www.premachining.com/Inquiry/ | devis en ligne gratuit et instantannée |  | 2nd Floor NO.39,Zhenan West Road,Chang An,Dong Guan,China 523878 | Inconnue | 86 138 2885 2656 86 138 2885 2656 | Quote@premachining.com
KinTec | https://www.kintec-machining.com/product/Custom-Aluminum-Machining.html | devis en ligne gratuit et instantannée |  | No.59 QingZhang Road, QingXi Town,DongGuan,China 523662 | Inconnue | 86 (0755) 2105 2909 | info@kintec-machining.com
