CoAuToSe/Robocup-SSL-Aquitaine/SSL Senior (Small Size League)/Robot_SSL_v1_NAMeC/Mécanique/Liste_outillages.xlsx

Liste Outillages
Nom de l'outil | Utilité | Quantité dans l'article | Nombre à acheter | Prix Unitaire (€) | Prix Total (€) | Liens achat | Images
Clé à molette large ouverture TRMW-36 | serrer les boulons | 1 | 1 | 16.64 | 16.64 | https://fr.misumi-ec.com/vona2/detail/223000770113/
Tournevis plats | visser/dévisser vis avec fente | 5 | 1 | 9.99 | 9.99 | https://www.amazon.fr/Dadabig-Tournevis-R%C3%A9paration-Horlogers-Precision/dp/B08237RWYD
Clé à 6 pans | visser/dévisser les visses à trou hexagonal | 13 | 1 | 10.98 | 10.98 | https://www.amazon.fr/Clefs-Hexagonales-pi%C3%A8ces-rotule-pratique/dp/B007R390IQ?s=hi
cutter
 |  |  |  | Total (€) | 37.61
