CoAuToSe/Robocup-SSL-Aquitaine/SSL Senior (Small Size League)/Robot_SSL_v1_NAMeC/Mécanique/Impression 3D/PETG/3d_Impression.step/main_shell_all-1 Esteban(7).STEP

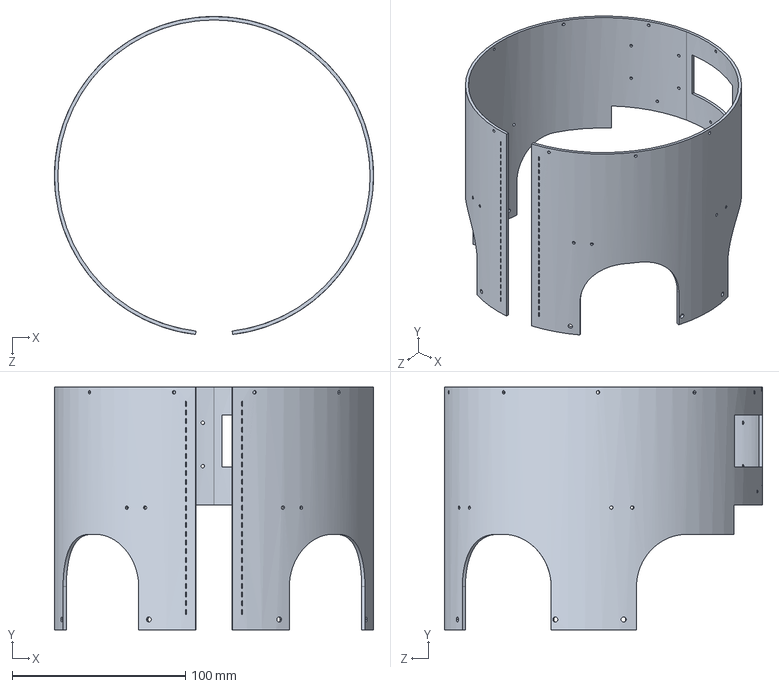
[picture p87: CAD file, 2022-09-01]
SSL Senior (Small Size League)/Robot_SSL_v1_NAMeC/Mécanique/Impression 3D/PETG/3d_Impression.step/main_shell_all-1 Esteban(7).STEP
184.0 x 140.0 x 183.4 mm
