CoAuToSe/Robocup-SSL-Aquitaine/SSL Senior (Small Size League)/Robot_SSL_v1_NAMeC/Mécanique/Impression 3D/PETG/3dImpressions.stl/main_shell2019.stl

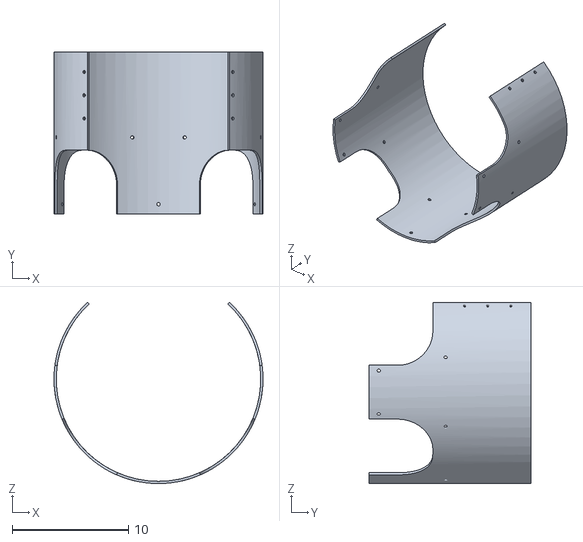
[picture p88: CAD file, 2022-09-01]
SSL Senior (Small Size League)/Robot_SSL_v1_NAMeC/Mécanique/Impression 3D/PETG/3dImpressions.stl/main_shell2019.stl
18.0 x 14.0 x 15.6
