CoAuToSe/Robocup-SSL-Aquitaine/SSL Senior (Small Size League)/Dribbler/Moules/En deux parties/Moule_f1_p5_p2.stl

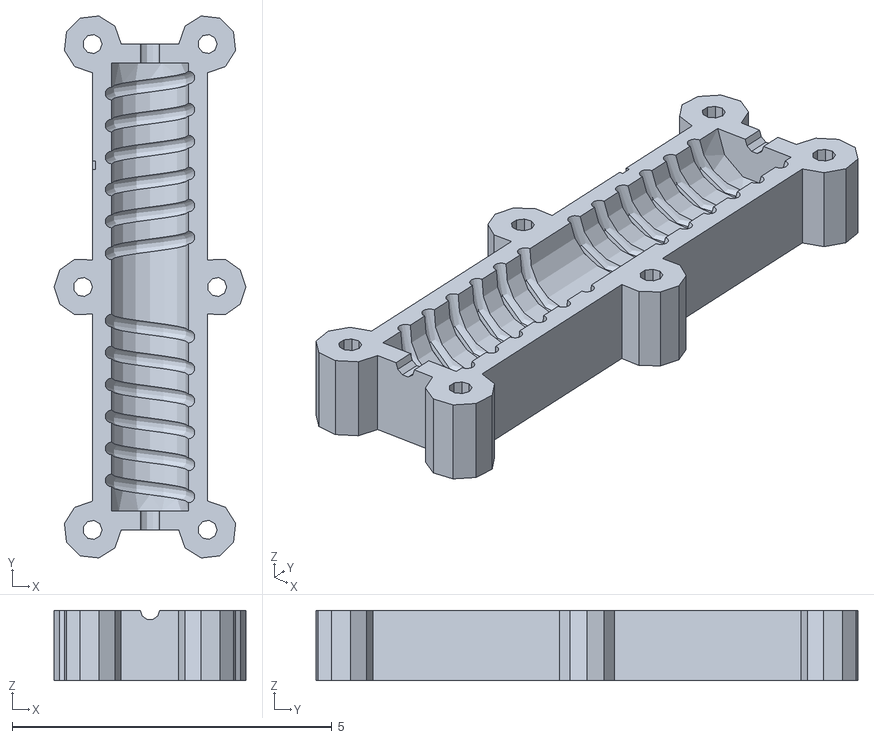
[picture p89: CAD file, 2022-09-01]
SSL Senior (Small Size League)/Dribbler/Moules/En deux parties/Moule_f1_p5_p2.stl
3.00 x 8.48 x 1.10
