CoAuToSe/Robocup-SSL-Aquitaine/SSL Senior (Small Size League)/Robot_SSL_v1_NAMeC/Mécanique/Découpe CNC Step/Kicker_Goupille_alu.stp

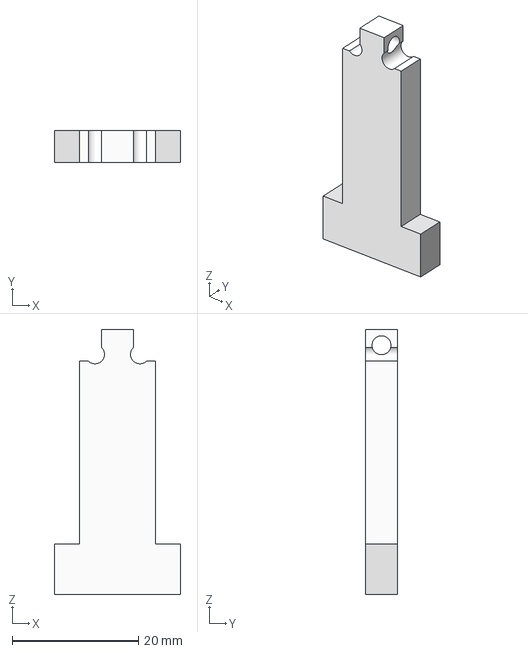
[picture p90: CAD file, 2022-09-01]
SSL Senior (Small Size League)/Robot_SSL_v1_NAMeC/Mécanique/Découpe CNC Step/Kicker_Goupille_alu.stp
20.0 x 5.00 x 42.0 mm
