CoAuToSe/Robocup-SSL-Aquitaine/SSL Senior (Small Size League)/Robot_SSL_v1_NAMeC/Mécanique/Impression 3D/PLA/3d_Impression.step/cerceau_front-1 Esteban(6).STEP

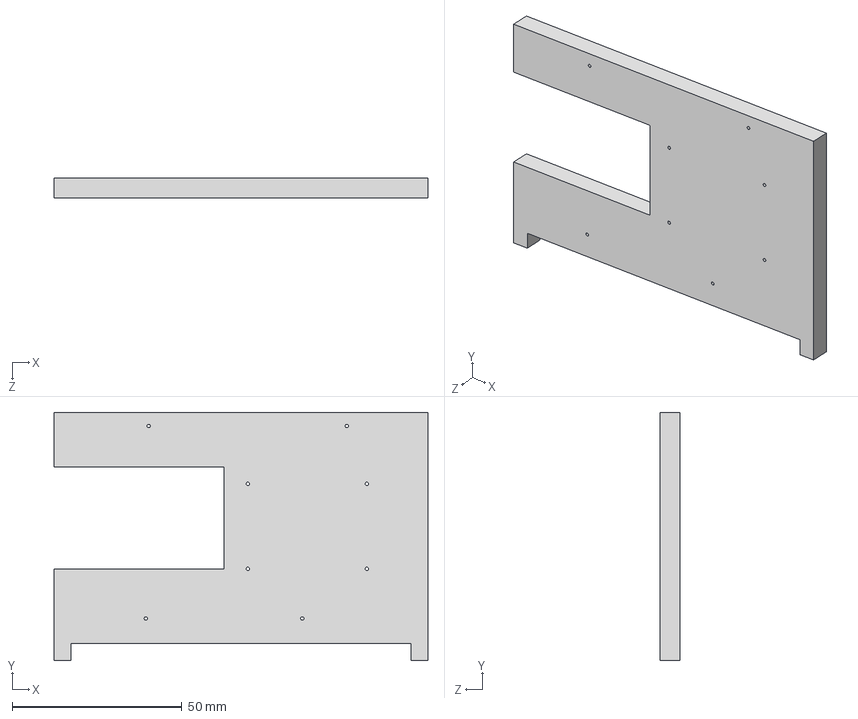
[picture p91: CAD file, 2022-09-01]
SSL Senior (Small Size League)/Robot_SSL_v1_NAMeC/Mécanique/Impression 3D/PLA/3d_Impression.step/cerceau_front-1 Esteban(6).STEP
110.0 x 73.0 x 6.00 mm
