CoAuToSe/Robocup-SSL-Aquitaine/SSL Senior (Small Size League)/Robot_SSL_v1_NAMeC/Mécanique/Impression 3D/PLA/3D_Impression.stl/brushless_elastic_support.stl

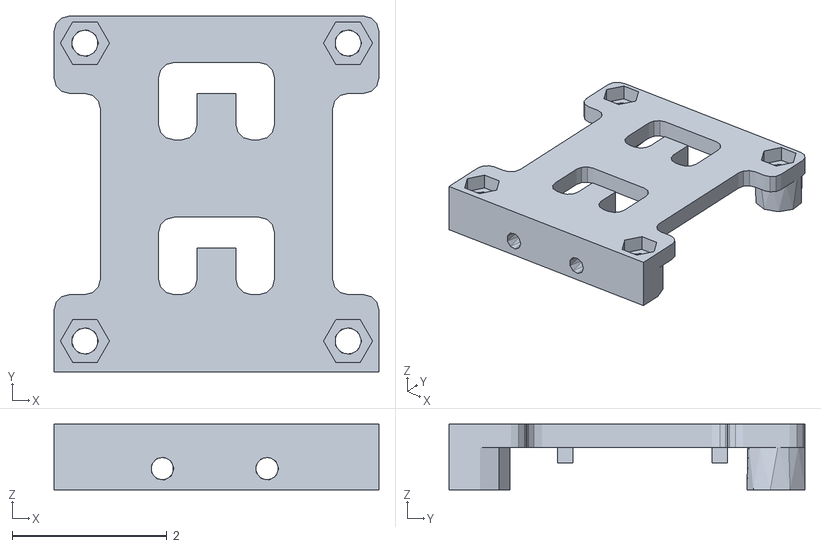
[picture p92: CAD file, 2022-09-01]
SSL Senior (Small Size League)/Robot_SSL_v1_NAMeC/Mécanique/Impression 3D/PLA/3D_Impression.stl/brushless_elastic_support.stl
4.20 x 4.60 x 0.85
