CoAuToSe/Robocup-SSL-Aquitaine/SSL Senior (Small Size League)/X-Proto 1/Impression 3D/13_Weel outer.stl

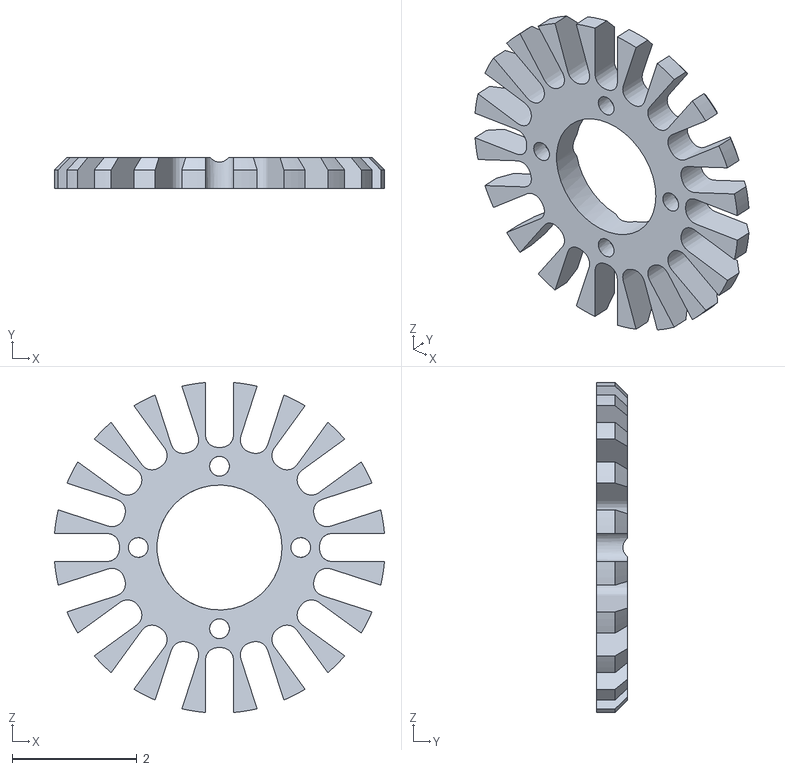
[picture p93: CAD file, 2022-09-01]
SSL Senior (Small Size League)/X-Proto 1/Impression 3D/13_Weel outer.stl
5.28 x 0.5 x 5.28
