CoAuToSe/Robocup-SSL-Aquitaine/SSL Senior (Small Size League)/Robot_SSL_v1_NAMeC/Mécanique/Découpe CNC Step/side_plate.stp

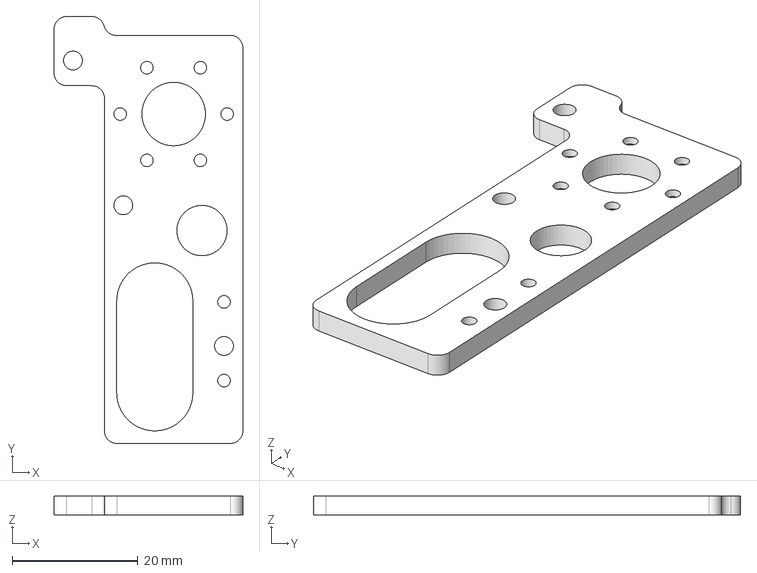
[picture p95: CAD file, 2022-09-01]
SSL Senior (Small Size League)/Robot_SSL_v1_NAMeC/Mécanique/Découpe CNC Step/side_plate.stp
30.0 x 67.8 x 3.00 mm
