CoAuToSe/Robocup-SSL-Aquitaine/SSL Senior (Small Size League)/Robot_SSL_v1_NAMeC/Mécanique/Impression 3D/PLA/3D_Impression.stl/kicker_tube.stl

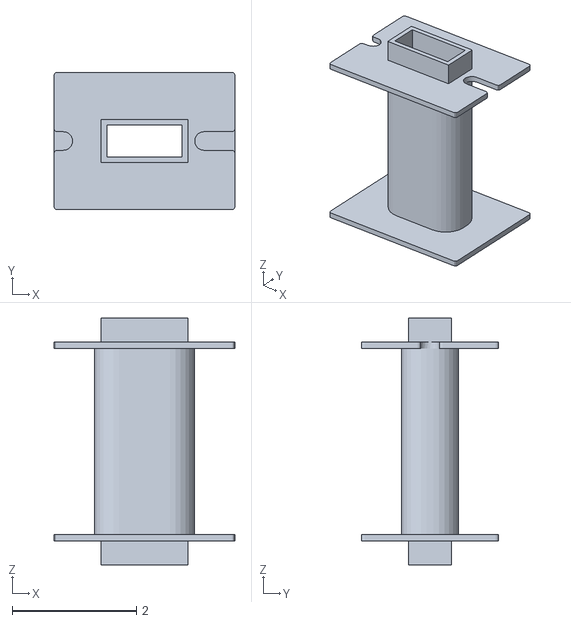
[picture p97: CAD file, 2022-09-01]
SSL Senior (Small Size League)/Robot_SSL_v1_NAMeC/Mécanique/Impression 3D/PLA/3D_Impression.stl/kicker_tube.stl
2.91 x 2.21 x 3.98
