CoAuToSe/Robocup-SSL-Aquitaine/SSL Senior (Small Size League)/X-Proto 1/Impression 3D/11_Wheel adapter.stl

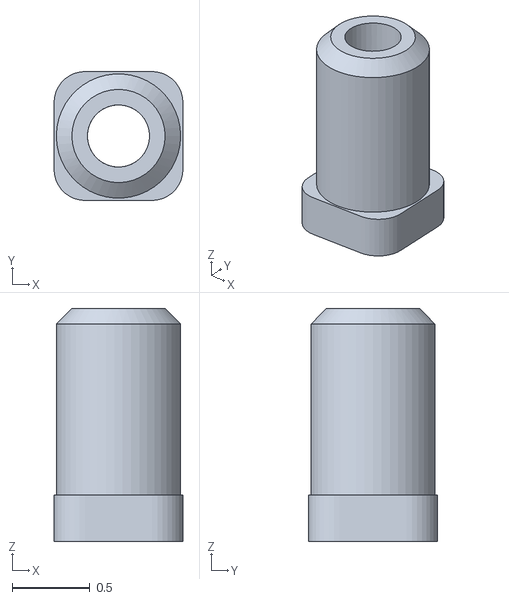
[picture p98: CAD file, 2022-09-01]
SSL Senior (Small Size League)/X-Proto 1/Impression 3D/11_Wheel adapter.stl
0.83 x 0.83 x 1.50
