CoAuToSe/Robocup-SSL-Aquitaine/SSL Senior (Small Size League)/Robot_SSL_v1_NAMeC/Mécanique/Découpe CNC Step/adapter_top.stp

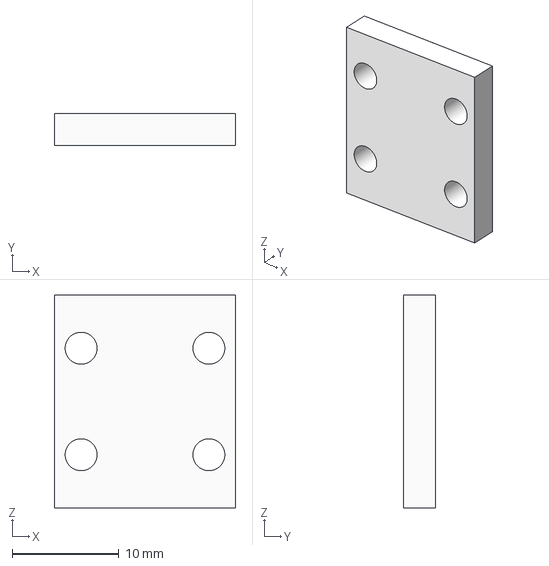
[picture p99: CAD file, 2022-09-01]
SSL Senior (Small Size League)/Robot_SSL_v1_NAMeC/Mécanique/Découpe CNC Step/adapter_top.stp
17.0 x 3.00 x 20.0 mm
