CoAuToSe/Robocup-SSL-Aquitaine/SSL Senior (Small Size League)/Robot_SSL_v1_NAMeC/Mécanique/Impression 3D/PETG/3dImpressions.stl/top_shell2.stl

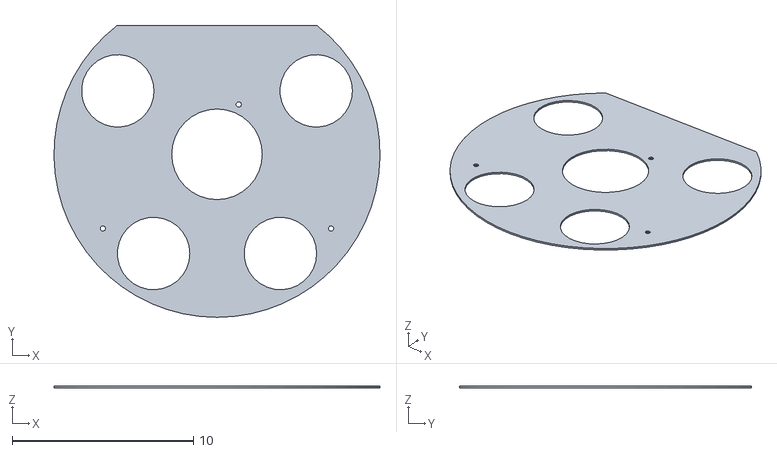
[picture p100: CAD file, 2022-09-01]
SSL Senior (Small Size League)/Robot_SSL_v1_NAMeC/Mécanique/Impression 3D/PETG/3dImpressions.stl/top_shell2.stl
18.0 x 16.1 x 0.1
