CoAuToSe/Robocup-SSL-Aquitaine/SSL Senior (Small Size League)/Robot_SSL_v1_NAMeC/Mécanique/Impression 3D/PLA/3D_Impression.stl/capacitor_glue.stl

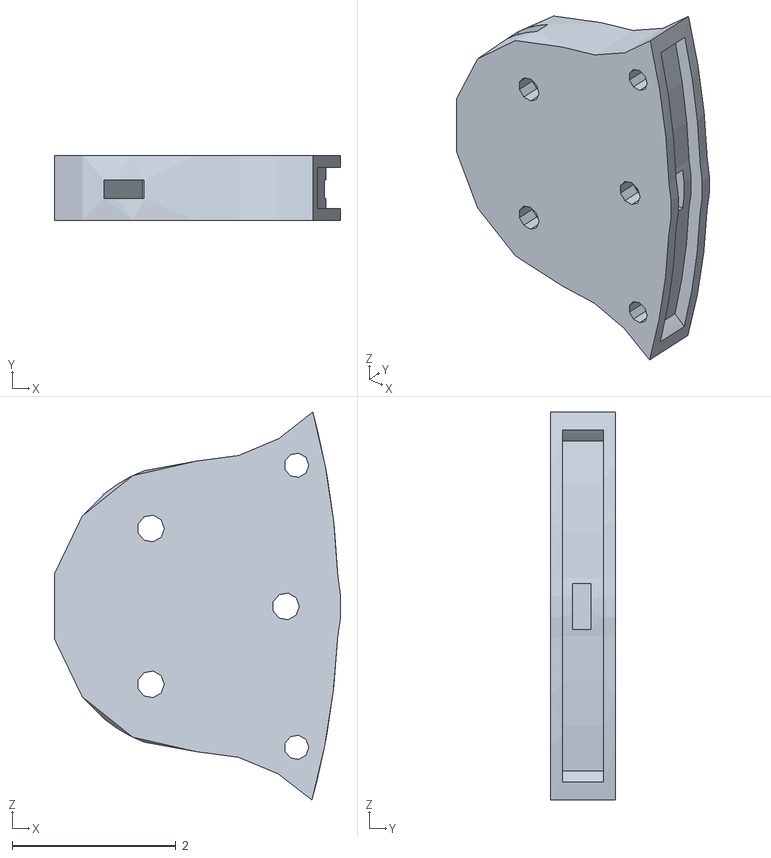
[picture p101: CAD file, 2022-09-01]
SSL Senior (Small Size League)/Robot_SSL_v1_NAMeC/Mécanique/Impression 3D/PLA/3D_Impression.stl/capacitor_glue.stl
3.50 x 0.8 x 4.74
