CoAuToSe/Robocup-SSL-Aquitaine/SSL Senior (Small Size League)/X-Proto 1/Impression 3D/10_Motor leg.stl

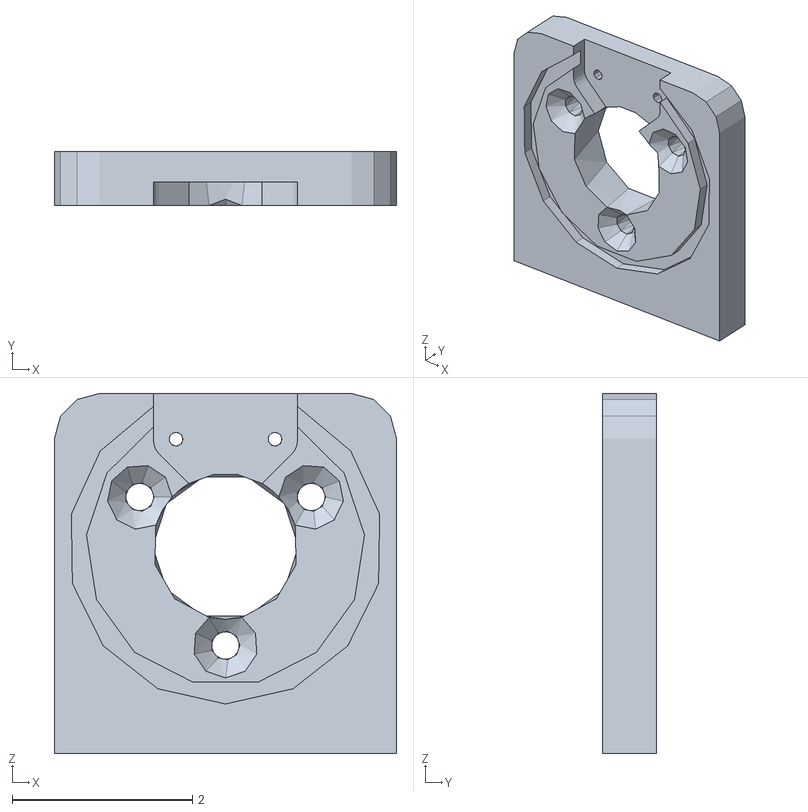
[picture p102: CAD file, 2022-09-01]
SSL Senior (Small Size League)/X-Proto 1/Impression 3D/10_Motor leg.stl
3.80 x 0.6 x 4.00
