CoAuToSe/Robocup-SSL-Aquitaine/SSL Senior (Small Size League)/Robot_SSL_v1_NAMeC/Mécanique/Découpe CNC Step/middle_base_plate.stp

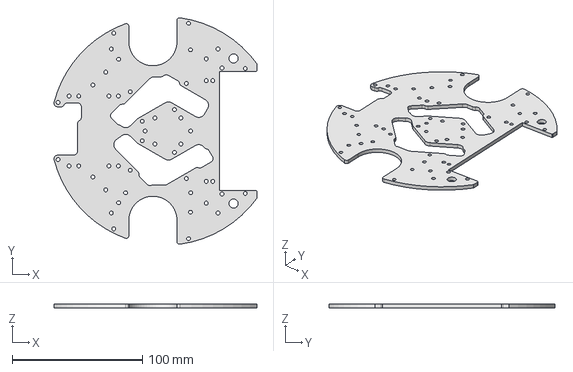
[picture p103: CAD file, 2022-09-01]
SSL Senior (Small Size League)/Robot_SSL_v1_NAMeC/Mécanique/Découpe CNC Step/middle_base_plate.stp
156.0 x 174.1 x 3.00 mm
