CoAuToSe/Robocup-SSL-Aquitaine/SSL Senior (Small Size League)/Robot_SSL_v1_NAMeC/Mécanique/Impression 3D/PLA/3D_Impression.stl/cerceau_front2019.stl

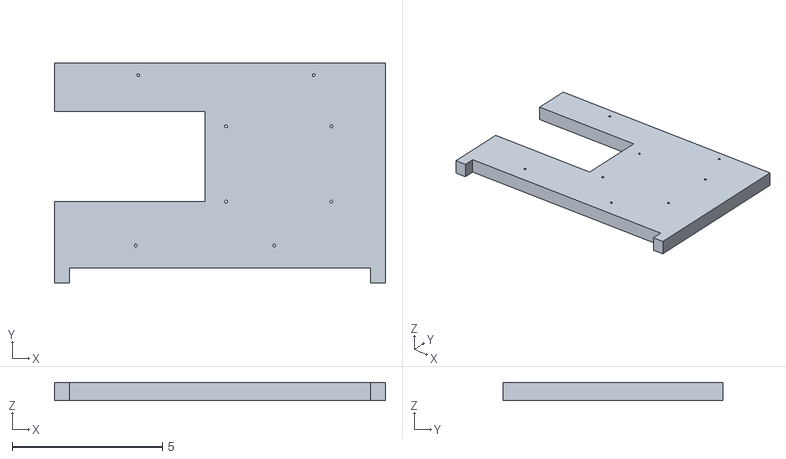
[picture p104: CAD file, 2022-09-01]
SSL Senior (Small Size League)/Robot_SSL_v1_NAMeC/Mécanique/Impression 3D/PLA/3D_Impression.stl/cerceau_front2019.stl
11.0 x 7.30 x 0.6
