CoAuToSe/Robocup-SSL-Aquitaine/SSL Senior (Small Size League)/X-Proto 1/Impression 3D/12_Wheel inner.stl

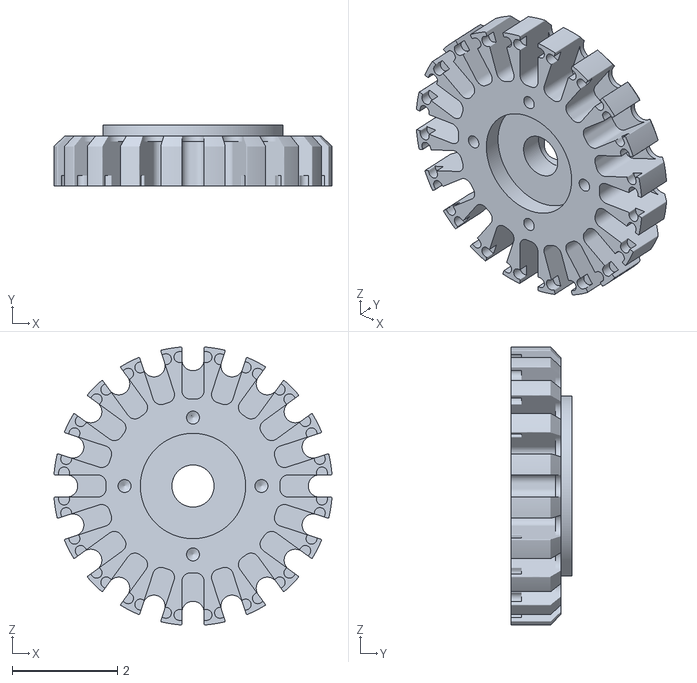
[picture p105: CAD file, 2022-09-01]
SSL Senior (Small Size League)/X-Proto 1/Impression 3D/12_Wheel inner.stl
5.28 x 1.16 x 5.28
