CoAuToSe/Robocup-SSL-Aquitaine/SSL Senior (Small Size League)/Robot_SSL_v1_NAMeC/Mécanique/Découpe CNC Step/kicker_plate.stp

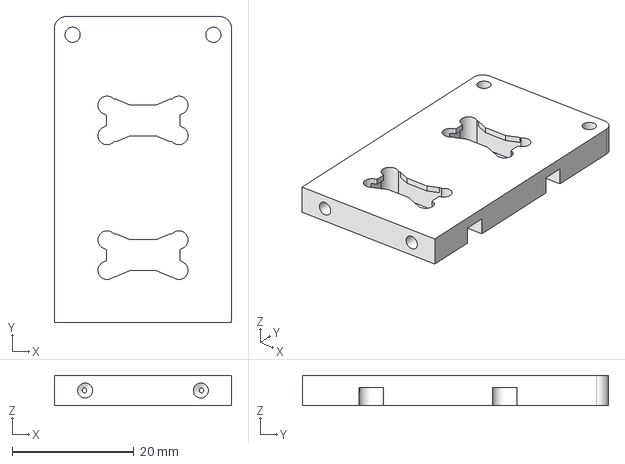
[picture p106: CAD file, 2022-09-01]
SSL Senior (Small Size League)/Robot_SSL_v1_NAMeC/Mécanique/Découpe CNC Step/kicker_plate.stp
29.1 x 50.2 x 5.00 mm
