CoAuToSe/Robocup-SSL-Aquitaine/SSL Senior (Small Size League)/Dribbler/Moules/En deux parties/Moule_d2_p1.stl

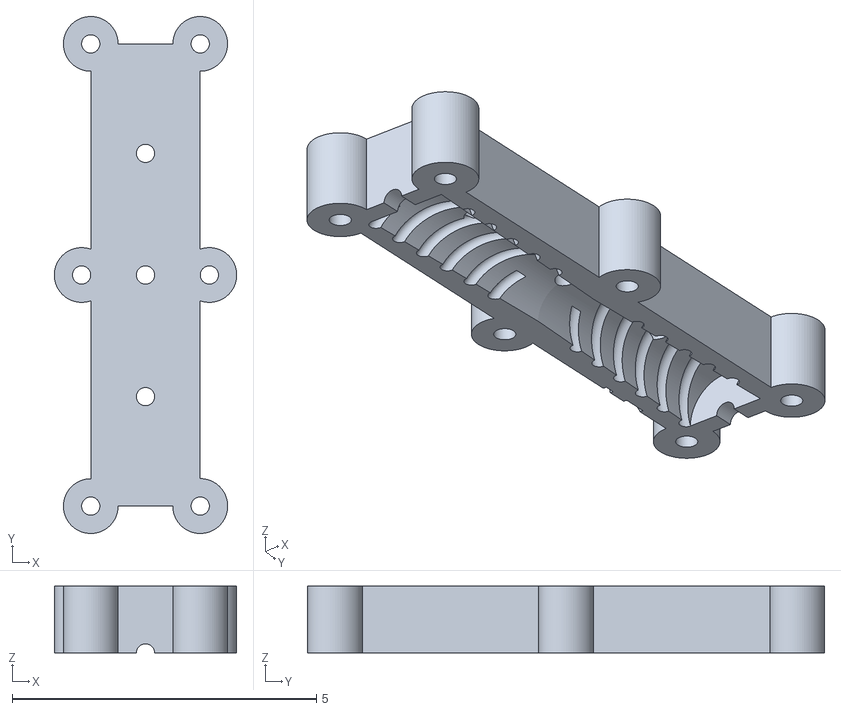
[picture p112: CAD file, 2022-09-01]
SSL Senior (Small Size League)/Dribbler/Moules/En deux parties/Moule_d2_p1.stl
3.00 x 8.50 x 1.10
