CoAuToSe/Robocup-SSL-Aquitaine/SSL Senior (Small Size League)/Robot_SSL_v1_NAMeC/Mécanique/Découpe CNC Step/BRUSHLESS3169.STEP.stp

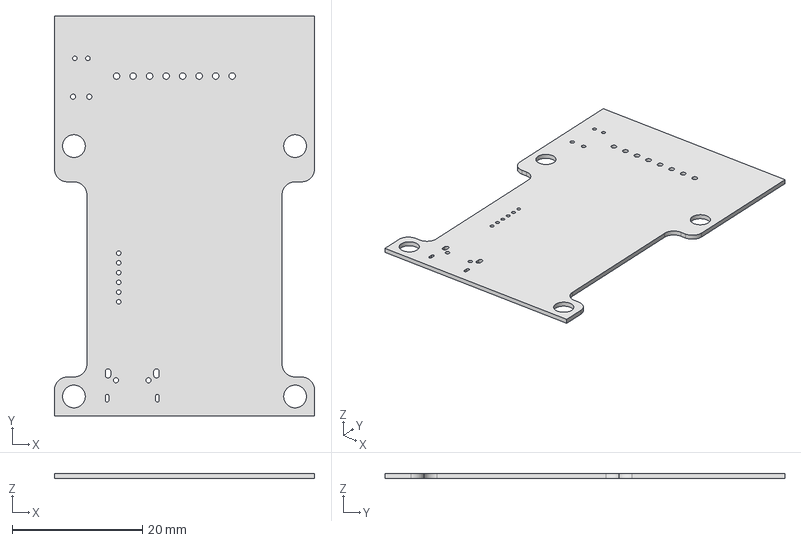
[picture p114: CAD file, 2022-09-01]
SSL Senior (Small Size League)/Robot_SSL_v1_NAMeC/Mécanique/Découpe CNC Step/BRUSHLESS3169.STEP.stp
40.0 x 61.5 x 0.798 mm
