CoAuToSe/Robocup-SSL-Aquitaine/SSL Senior (Small Size League)/Robot_SSL_v1_NAMeC/Mécanique/Découpe CNC Step/lower_baseplate_collet_alu.stp

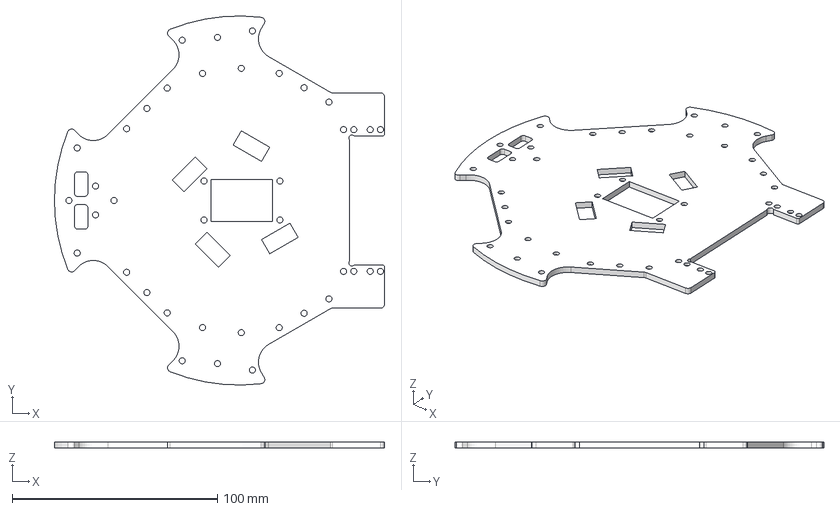
[picture p120: CAD file, 2022-09-01]
SSL Senior (Small Size League)/Robot_SSL_v1_NAMeC/Mécanique/Découpe CNC Step/lower_baseplate_collet_alu.stp
161.0 x 180.0 x 3.00 mm
