CoAuToSe/Robocup-SSL-Aquitaine/(list of files, cad)

Other CAD files:
SSL Senior (Small Size League)/Dribbler/Moules/En deux parties/Moule_f2_p_p2.stl
SSL Senior (Small Size League)/Dribbler/Moules/En deux parties/Moule_f1_p5_p1.stl
SSL Senior (Small Size League)/Dribbler/Moules/En deux parties/Moule_d4_p2.stl
SSL Senior (Small Size League)/Dribbler/Moules/En deux parties/Moule_f3_p_p2.stl
SSL Senior (Small Size League)/Dribbler/Moules/En deux parties/Moule_f4_p2.stl
SSL Senior (Small Size League)/Dribbler/Moules/En deux parties/Moule_f3_p_p1.stl
SSL Senior (Small Size League)/Dribbler/Moules/En deux parties/Moule_d4_p1.stl
SSL Senior (Small Size League)/Dribbler/Moules/En deux parties/Moule_d2_p1.ipt
SSL Senior (Small Size League)/Dribbler/Moules/En deux parties/Moule_d2_p2.ipt
SSL Senior (Small Size League)/Dribbler/Moules/En deux parties/Moule_d4_p1.ipt
SSL Senior (Small Size League)/Dribbler/Moules/En deux parties/Moule_d4_p2.ipt
SSL Senior (Small Size League)/Dribbler/Moules/En deux parties/Moule_f1_p5_p1.ipt
SSL Senior (Small Size League)/Dribbler/Moules/En deux parties/Moule_f1_p5_p2.ipt
SSL Senior (Small Size League)/Dribbler/Moules/En deux parties/Moule_f2_p_p1.ipt
SSL Senior (Small Size League)/Dribbler/Moules/En deux parties/Moule_f2_p_p2.ipt
SSL Senior (Small Size League)/Dribbler/Moules/En deux parties/Moule_f3_p_p1.ipt
SSL Senior (Small Size League)/Dribbler/Moules/En deux parties/Moule_f3_p_p2.ipt
SSL Senior (Small Size League)/Dribbler/Moules/En deux parties/Moule_f4_p1.ipt
SSL Senior (Small Size League)/Dribbler/Moules/En deux parties/Moule_f4_p2.ipt
SSL Senior (Small Size League)/Dribbler/Moules/En une partie/Moule_d2.ipt
SSL Senior (Small Size League)/Dribbler/Moules/En une partie/Moule_d4.ipt
SSL Senior (Small Size League)/Dribbler/Moules/En une partie/Moule_f1_p5.ipt
SSL Senior (Small Size League)/Dribbler/Moules/En une partie/Moule_f2_p.ipt
SSL Senior (Small Size League)/Dribbler/Moules/En une partie/Moule_f3_p.ipt
SSL Senior (Small Size League)/Dribbler/Moules/En une partie/Moule_f4.ipt
SSL Senior (Small Size League)/Robot_SSL_v1_NAMeC/Mécanique/Découpe CNC Step/collet_screw.stp
SSL Senior (Small Size League)/Robot_SSL_v1_NAMeC/Mécanique/Découpe CNC propre/BRUSHLESS3169.STEP.IPT
SSL Senior (Small Size League)/Robot_SSL_v1_NAMeC/Mécanique/Découpe CNC propre/Kicker_Goupille_Alu.ipt
SSL Senior (Small Size League)/Robot_SSL_v1_NAMeC/Mécanique/Découpe CNC propre/adapter_bottom.ipt
SSL Senior (Small Size League)/Robot_SSL_v1_NAMeC/Mécanique/Découpe CNC propre/adapter_top.ipt
SSL Senior (Small Size League)/Robot_SSL_v1_NAMeC/Mécanique/Découpe CNC propre/base.ipt
SSL Senior (Small Size League)/Robot_SSL_v1_NAMeC/Mécanique/Découpe CNC propre/collet_screw.ipt
SSL Senior (Small Size League)/Robot_SSL_v1_NAMeC/Mécanique/Découpe CNC propre/kicker_plate.ipt
SSL Senior (Small Size League)/Robot_SSL_v1_NAMeC/Mécanique/Découpe CNC propre/lower_baseplate_collet_alu.ipt
SSL Senior (Small Size League)/Robot_SSL_v1_NAMeC/Mécanique/Découpe CNC propre/middle_base_plate.ipt
SSL Senior (Small Size League)/Robot_SSL_v1_NAMeC/Mécanique/Découpe CNC propre/plate1_3mm_m6collet.ipt
SSL Senior (Small Size League)/Robot_SSL_v1_NAMeC/Mécanique/Découpe CNC propre/plate1_m6collet.ipt
SSL Senior (Small Size League)/Robot_SSL_v1_NAMeC/Mécanique/Découpe CNC propre/side_plate.ipt
SSL Senior (Small Size League)/Robot_SSL_v1_NAMeC/Mécanique/Découpe CNC propre/tap_straight.ipt
SSL Senior (Small Size League)/Robot_SSL_v1_NAMeC/Mécanique/Découpe CNC propre/tap_straight_bottom.ipt
SSL Senior (Small Size League)/Robot_SSL_v1_NAMeC/Mécanique/Découpe CNC propre/wheel_fix_plate_collet.ipt
SSL Senior (Small Size League)/Robot_SSL_v1_NAMeC/Mécanique/Impression 3D/PETG/3dImpressions.ipt/main_shell2019.ipt
SSL Senior (Small Size League)/Robot_SSL_v1_NAMeC/Mécanique/Impression 3D/PETG/3dImpressions.ipt/top_shell.ipt
SSL Senior (Small Size League)/Robot_SSL_v1_NAMeC/Mécanique/Impression 3D/PETG/3dImpressions.ipt/top_shell2.ipt
SSL Senior (Small Size League)/Robot_SSL_v1_NAMeC/Mécanique/Impression 3D/PLA/3D_Impression.Ipt/brushless_elastic_support.ipt
SSL Senior (Small Size League)/Robot_SSL_v1_NAMeC/Mécanique/Impression 3D/PLA/3D_Impression.Ipt/capacitor_glue.ipt
SSL Senior (Small Size League)/Robot_SSL_v1_NAMeC/Mécanique/Impression 3D/PLA/3D_Impression.Ipt/capacitor_glueESME.ipt
SSL Senior (Small Size League)/Robot_SSL_v1_NAMeC/Mécanique/Impression 3D/PLA/3D_Impression.Ipt/cerceau_front2019.ipt
SSL Senior (Small Size League)/Robot_SSL_v1_NAMeC/Mécanique/Impression 3D/PLA/3D_Impression.Ipt/kicker_tube.ipt
SSL Senior (Small Size League)/Robot_SSL_v1_NAMeC/Mécanique/Impression 3D/PLA/3D_Impression.Ipt/middleplate.ipt
