CoAuToSe/Robocup-SSL-Aquitaine/SSL Senior (Small Size League)/Liste_pieces_fabrication_naelic_11_11_2021.xlsx

Pièces ALUMINIUM NAELIC VF |  |  | Pièces LIT DE POUDRE NAELIC VF |  |  | Pièces IMPRESSION 3D NAELIC VF
Nom | Nombre dans 1 robot | "==" piece liste Jade | Nom | Nombre dans 1 robot |  | Nom | Nombre dans 1 robot
TOLE BATI INFERIEUR ALU | 1 | TRUE | TUBE KICKER LDP | 2 | TRUE | SUPPORT DE CONDENSATEUR PLA | 1
TOLE BATI SUPERIEUR ALU | 1 | TRUE | RAMPE LDP | 1 | TRUE
PIED KICKER ALU | 2 | TRUE
REPRISE KICKER ALU | 2 | TRUE
SUPPORT MOTEUR ROUE ALU | 4 | TRUE
PLAQUE ROUE AVANT ALU | 4 | TRUE | Pièces ACIER NAELIC VF
PLAQUE ROUE ARRIERE ALU | 4 | TRUE | Nom | Nombre dans 1 robot
SUPPORT BOBINE ALU | 2 | TRUE | KICKER GOUPILLE 1 ACIER | 1 | TRUE
KICKER COURT ALU | 1 | TRUE
KICKER LARGE ALU | 1 | TRUE
REPRISE KICKER COURTE ALU | 1 | TRUE
REPRISE KICKER LONGUE ALU | 1 | TRUE
KICKER GOUPILLE 2 ALU | 2 | TRUE
