CoAuToSe/Robocup-SSL-Aquitaine/SSL Senior (Small Size League)/Robot_SSL_v1_NAMeC/Electronique/kicker/kicker.brd

## EAGLE design SSL Senior (Small Size League)/Robot_SSL_v1_NAMeC/Electronique/kicker/kicker.brd (2022-09-01)

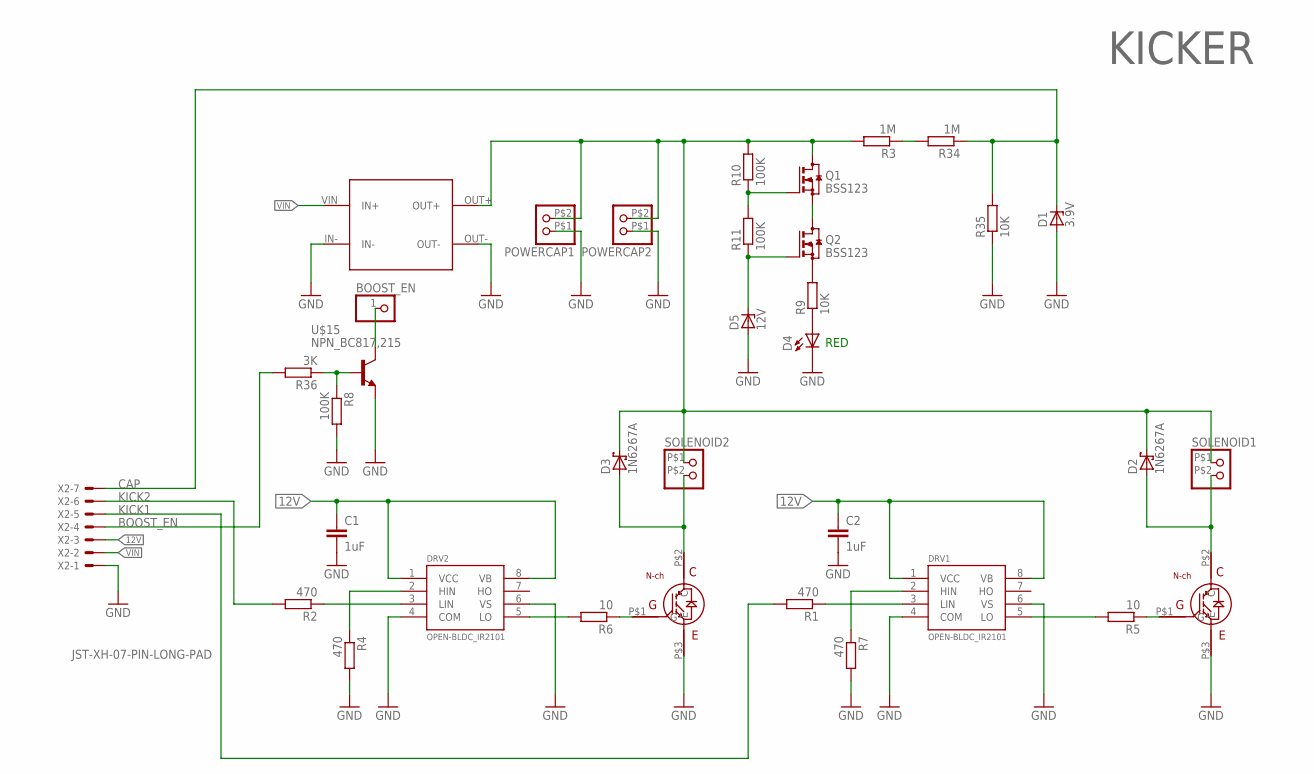
[picture p121: schematic kicker.sch]

Parts:
BOOST_EN: CONNEC_1X01
C1, C2: 1uF; C0805
D1: 3.9V; SOD80C; FARNELL 1097198
D2, D3: 1N6267A; C4111-15; FARNELL 9551735
D4: RED; LED-1206; FARNELL 1581233
D5: 12V; SOD80C; FARNELL 2319144
DRV1, DRV2: OPEN-BLDC_IR2101; OPEN-BLDC_SO-8; FARNELL 8638730
POWERCAP1, POWERCAP2: CONNEC_1X02BIG; CONNEC_1X02_BIG
Q1, Q2: BSS123; SOT23
R1, R2, R4, R7: 470; R0805; FARNELL 2446965
R3, R34: 1M; R0805; FARNELL 2129375
R5, R6: 10; R0805; FARNELL 2446965
R8: 100K; R0805; FARNELL 2446965
R9, R35: 10K; R0805; FARNELL 2447553
R10, R11: 100K; R0805; FARNELL 2447553
R36: 3K; R0805; FARNELL 2446965
SOLENOID1, SOLENOID2: CONNEC_1X02BIG; CONNEC_1X02_BIG
U$1, U$11: TO-247A; TO-247; FARNELL 2429705
U$5: BOOSTER; BOOSTER_390V
U$15: NPN_BC817,215; SOT-23; FARNELL 1081223
X2: JST-XH-07-PIN-LONG-PAD; JST-XH-07-PACKAGE-LONG-PAD

Connections:
12V: C1.1, C2.1, DRV1.1 (VCC), DRV1.8 (VB), DRV2.1 (VCC), DRV2.8 (VB), X2.3
BOOST_EN: R36.2, X2.4
CAP: D1.C, R34.1, R35.2, X2.7
GND: C1.2, C2.2, D1.A, D4.C, D5.A, DRV1.4 (COM), DRV1.6 (VS), DRV2.4 (COM), DRV2.6 (VS), POWERCAP1.P$1 (1), POWERCAP2.P$1 (1), R4.2, R7.2, R8.2, R35.1, U$1.P$3 (E), U$5.IN-, U$5.OUT-, U$11.P$3 (E), U$15.2 (E), X2.1
KICK1: R1.2, X2.5
KICK2: R2.2, X2.6
unnamed: DRV2.3 (LIN), R2.1
unnamed: D2.A, SOLENOID1.P$2 (2), U$1.P$2 (C)
unnamed: DRV2.5 (LO), R6.2
unnamed: R3.1, R34.2
unnamed: DRV1.3 (LIN), R1.1
unnamed: DRV2.2 (HIN), R4.1
unnamed: R5.1, U$1.P$1 (G)
unnamed: R6.1, U$11.P$1 (G)
unnamed: DRV1.5 (LO), R5.2
unnamed: Q2.2 (S), R9.2
unnamed: D4.A, R9.1
unnamed: Q1.2 (S), Q2.3 (D)
unnamed: DRV1.2 (HIN), R7.1
unnamed: Q1.1 (G), R10.1, R11.2
unnamed: D5.C, Q2.1 (G), R11.1
unnamed: D3.A, SOLENOID2.P$2 (2), U$11.P$2 (C)
unnamed: BOOST_EN.1, U$15.3 (C)
unnamed: R8.1, R36.1, U$15.1 (B)
VBOOST: D2.C, D3.C, POWERCAP1.P$2 (2), POWERCAP2.P$2 (2), Q1.3 (D), R3.2, R10.2, SOLENOID1.P$1 (1), SOLENOID2.P$1 (1), U$5.OUT+
VIN: U$5.VIN (IN+), X2.2

Notes on the sheet:
KICKER
RED

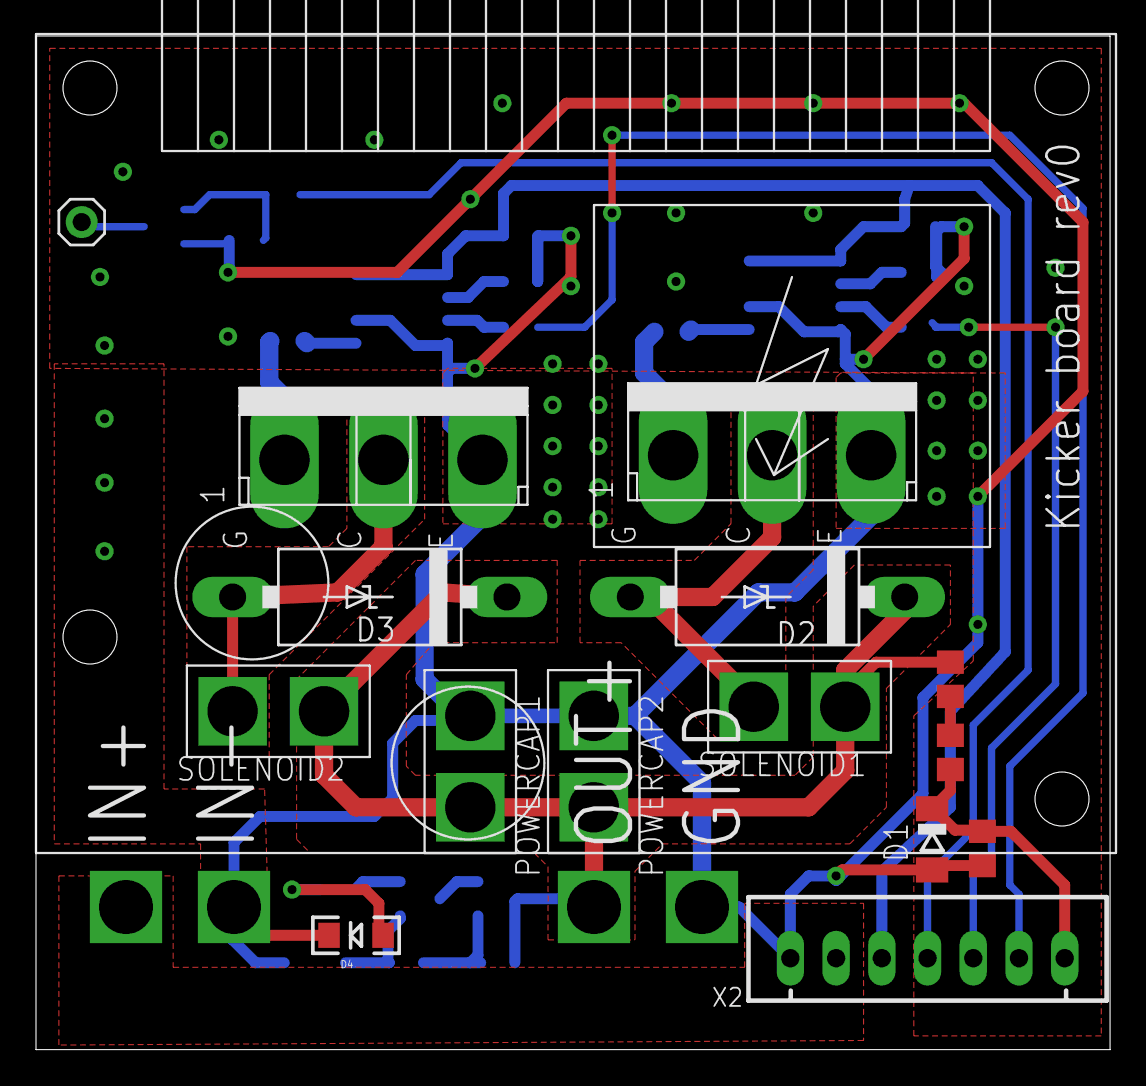
[picture p122: board kicker.brd from above]

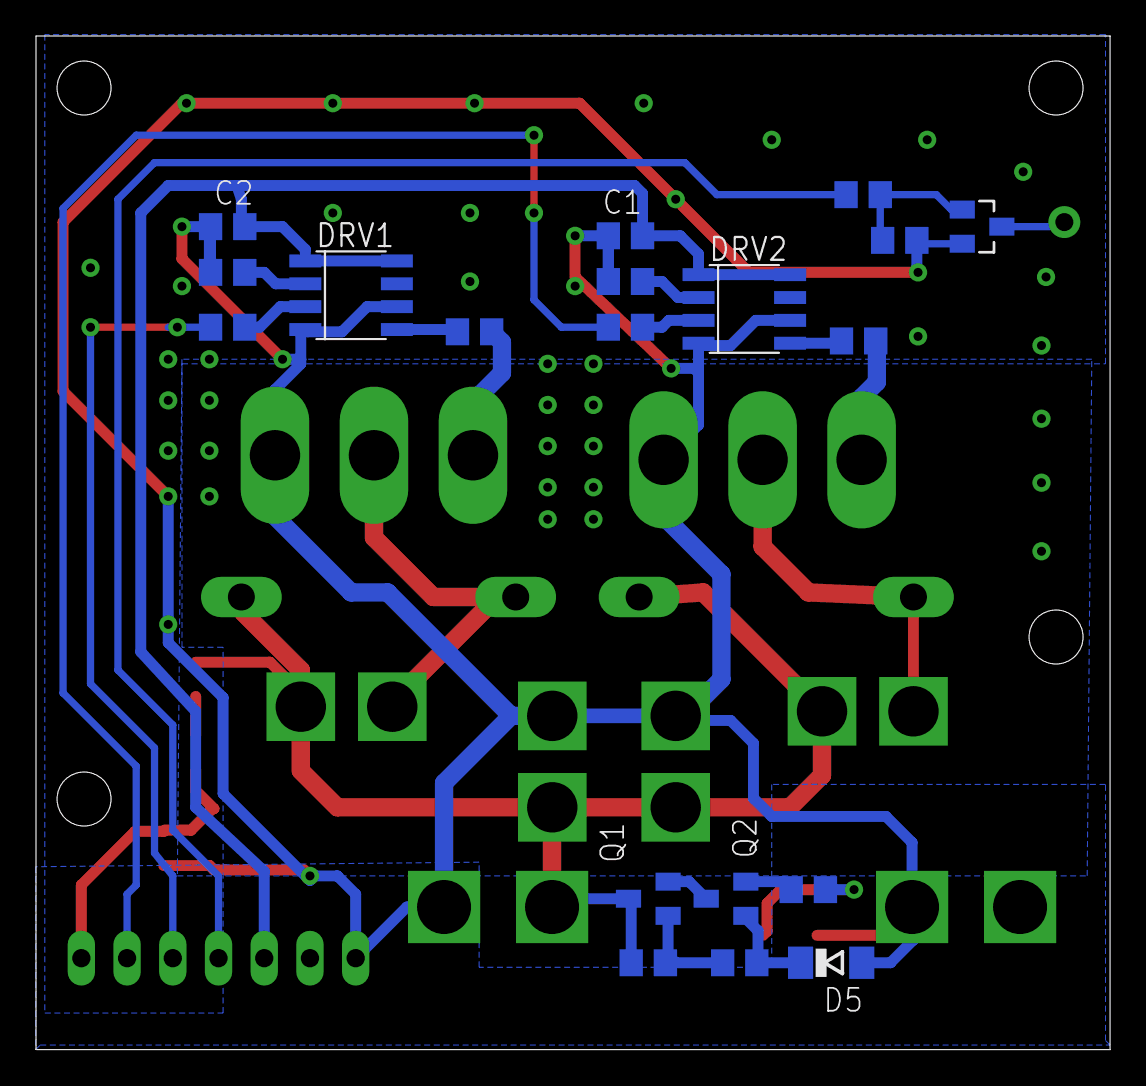
[picture p123: board kicker.brd from below]

Board: 2 copper layers, 59.7 x 56.3 mm, 35 parts (19 on the bottom side), 26 nets.
