CoAuToSe/Robocup-SSL-Aquitaine/SSL Senior (Small Size League)/Robot_SSL_v1_NAMeC/Electronique/brushless/brushless.brd

## EAGLE design SSL Senior (Small Size League)/Robot_SSL_v1_NAMeC/Electronique/brushless/brushless.brd (2022-09-01)

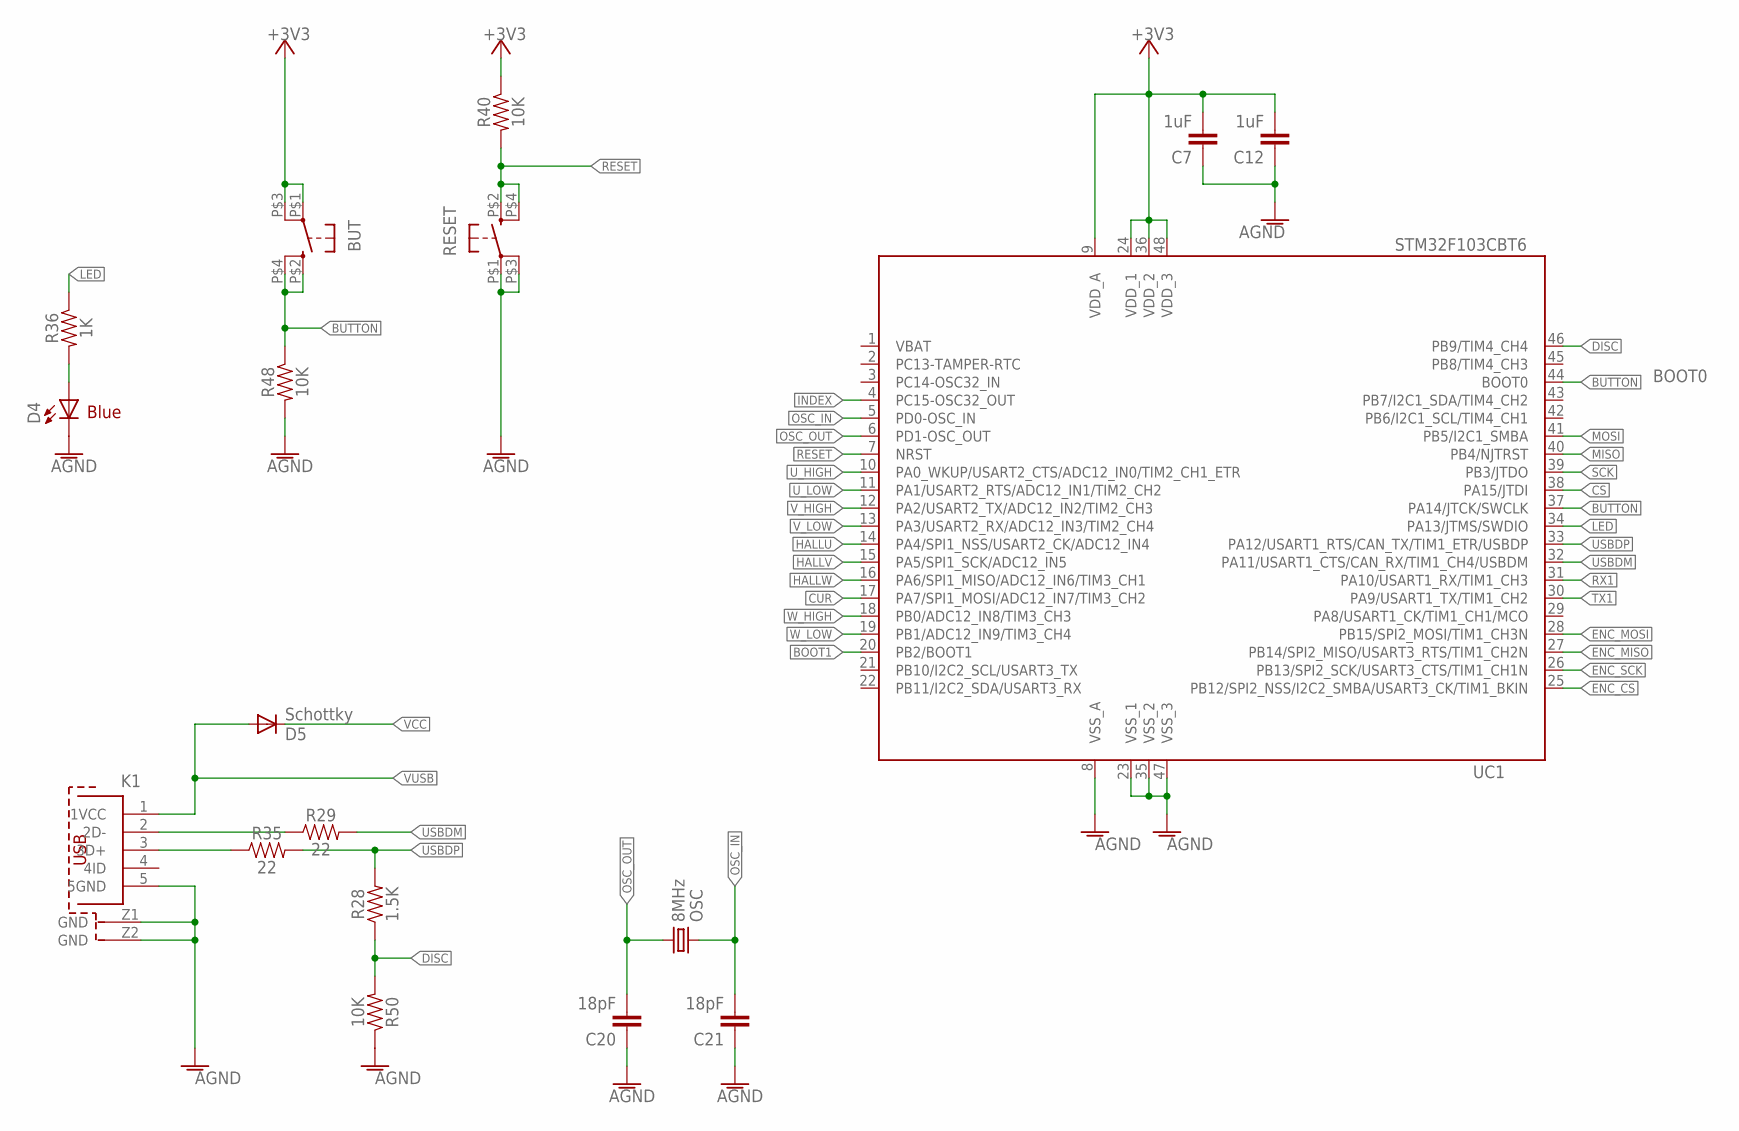
[picture p124: schematic brushless.sch, sheet 1]

Parts:
BUT: KMR211GLFS; PUSHBUTTON-KMR241GLFS; FARNELL 1437637
C7, C12: 1uF; 0805@1; FARNELL 2496946
C20, C21: 18pF; 0805@1; FARNELL 1414620
D4: Blue; LED-1206; FARNELL 1581233
D5: Schottky; SOD-323; FARNELL 2760406
K1: 614105150721; FARNELL 2470821
OSC: 8MHz; CRYSTAL-SMD-5X3; FARNELL 2467818
R28: 1.5K; 0805; FARNELL 2446909
R29, R35: 22; 0805; FARNELL 2446926
R36: 1K; 0805; FARNELL 2446904
R40, R48, R50: 10K; 0805; FARNELL 2447553
RESET: KMR211GLFS; PUSHBUTTON-KMR241GLFS; FARNELL 1437637
UC1: STM32F103CBT6; STM32_LQFP48; FARNELL 1606327

Connections:
+3V3: BUT.P$1 (1), BUT.P$3 (3), C7.2, C12.2, R40.1, UC1.9 (VDD_A), UC1.24 (VDD_1), UC1.36 (VDD_2), UC1.48 (VDD_3); also elsewhere on the board
AGND: C7.1, C12.1, C20.1, C21.1, D4.C, K1.5 (5GND), K1.Z1 (GND), K1.Z2 (GND), R48.2, R50.1, RESET.P$1 (1), RESET.P$3 (3), UC1.8 (VSS_A), UC1.23 (VSS_1), UC1.35 (VSS_2), UC1.47 (VSS_3); also elsewhere on the board
BOOT1: UC1.20 (PB2/BOOT1)
BUTTON: BUT.P$2 (2), BUT.P$4 (4), R48.1, UC1.37 (PA14/JTCK/SWCLK), UC1.44 (BOOT0)
CS: UC1.38 (PA15/JTDI); also elsewhere on the board
CUR: UC1.17 (PA7/SPI1_MOSI/ADC12_IN7/TIM3_CH2); also elsewhere on the board
DISC: R28.1, R50.2, UC1.46 (PB9/TIM4_CH4)
ENC_CS: UC1.25 (PB12/SPI2_NSS/I2C2_SMBA/USART3_CK/TIM1_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); also elsewhere on the board
ENC_MISO: UC1.27 (PB14/SPI2_MISO/USART3_RTS/TIM1_CH2N); also elsewhere on the board
ENC_MOSI: UC1.28 (PB15/SPI2_MOSI/TIM1_CH3N); also elsewhere on the board
ENC_SCK: UC1.26 (PB13/SPI2_SCK/USART3_CTS/TIM1_CH1N); also elsewhere on the board
HALLU: UC1.14 (PA4/SPI1_NSS/USART2_CK/ADC12_IN4); also elsewhere on the board
HALLV: UC1.15 (PA5/SPI1_SCK/ADC12_IN5); also elsewhere on the board
HALLW: UC1.16 (PA6/SPI1_MISO/ADC12_IN6/TIM3_CH1); also elsewhere on the board
INDEX: UC1.4 (PC15-OSC32_OUT)
LED: R36.1, UC1.34 (PA13/JTMS/SWDIO)
MISO: UC1.40 (PB4/NJTRST); also elsewhere on the board
MOSI: UC1.41 (PB5/I2C1_SMBA); also elsewhere on the board
unnamed: D4.A, R36.2
unnamed: K1.2 (2D-), R29.1
unnamed: K1.3 (3D+), R35.1
OSC_IN: C21.2, OSC.3 (2), UC1.5 (PD0-OSC_IN)
OSC_OUT: C20.2, OSC.1, UC1.6 (PD1-OSC_OUT)
RESET: R40.2, RESET.P$2 (2), RESET.P$4 (4), UC1.7 (NRST)
RX1: UC1.31 (PA10/USART1_RX/TIM1_CH3)
SCK: UC1.39 (PB3/JTDO); also elsewhere on the board
TX1: UC1.30 (PA9/USART1_TX/TIM1_CH2)
USBDM: R29.2, UC1.32 (PA11/USART1_CTS/CAN_RX/TIM1_CH4/USBDM)
USBDP: R28.2, R35.2, UC1.33 (PA12/USART1_RTS/CAN_TX/TIM1_ETR/USBDP)
U_HIGH: UC1.10 (PA0_WKUP/USART2_CTS/ADC12_IN0/TIM2_CH1_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); also elsewhere on the board
U_LOW: UC1.11 (PA1/USART2_RTS/ADC12_IN1/TIM2_CH2); also elsewhere on the board
VBAT: UC1.1 (VBAT)
VCC: D5.1 (C); also elsewhere on the board
VUSB: D5.2 (A), K1.1 (1VCC); also elsewhere on the board
V_HIGH: UC1.12 (PA2/USART2_TX/ADC12_IN2/TIM2_CH3); also elsewhere on the board
V_LOW: UC1.13 (PA3/USART2_RX/ADC12_IN3/TIM2_CH4); also elsewhere on the board
W_HIGH: UC1.18 (PB0/ADC12_IN8/TIM3_CH3); also elsewhere on the board
W_LOW: UC1.19 (PB1/ADC12_IN9/TIM3_CH4); also elsewhere on the board

Notes on the sheet:
BOOT0
Blue

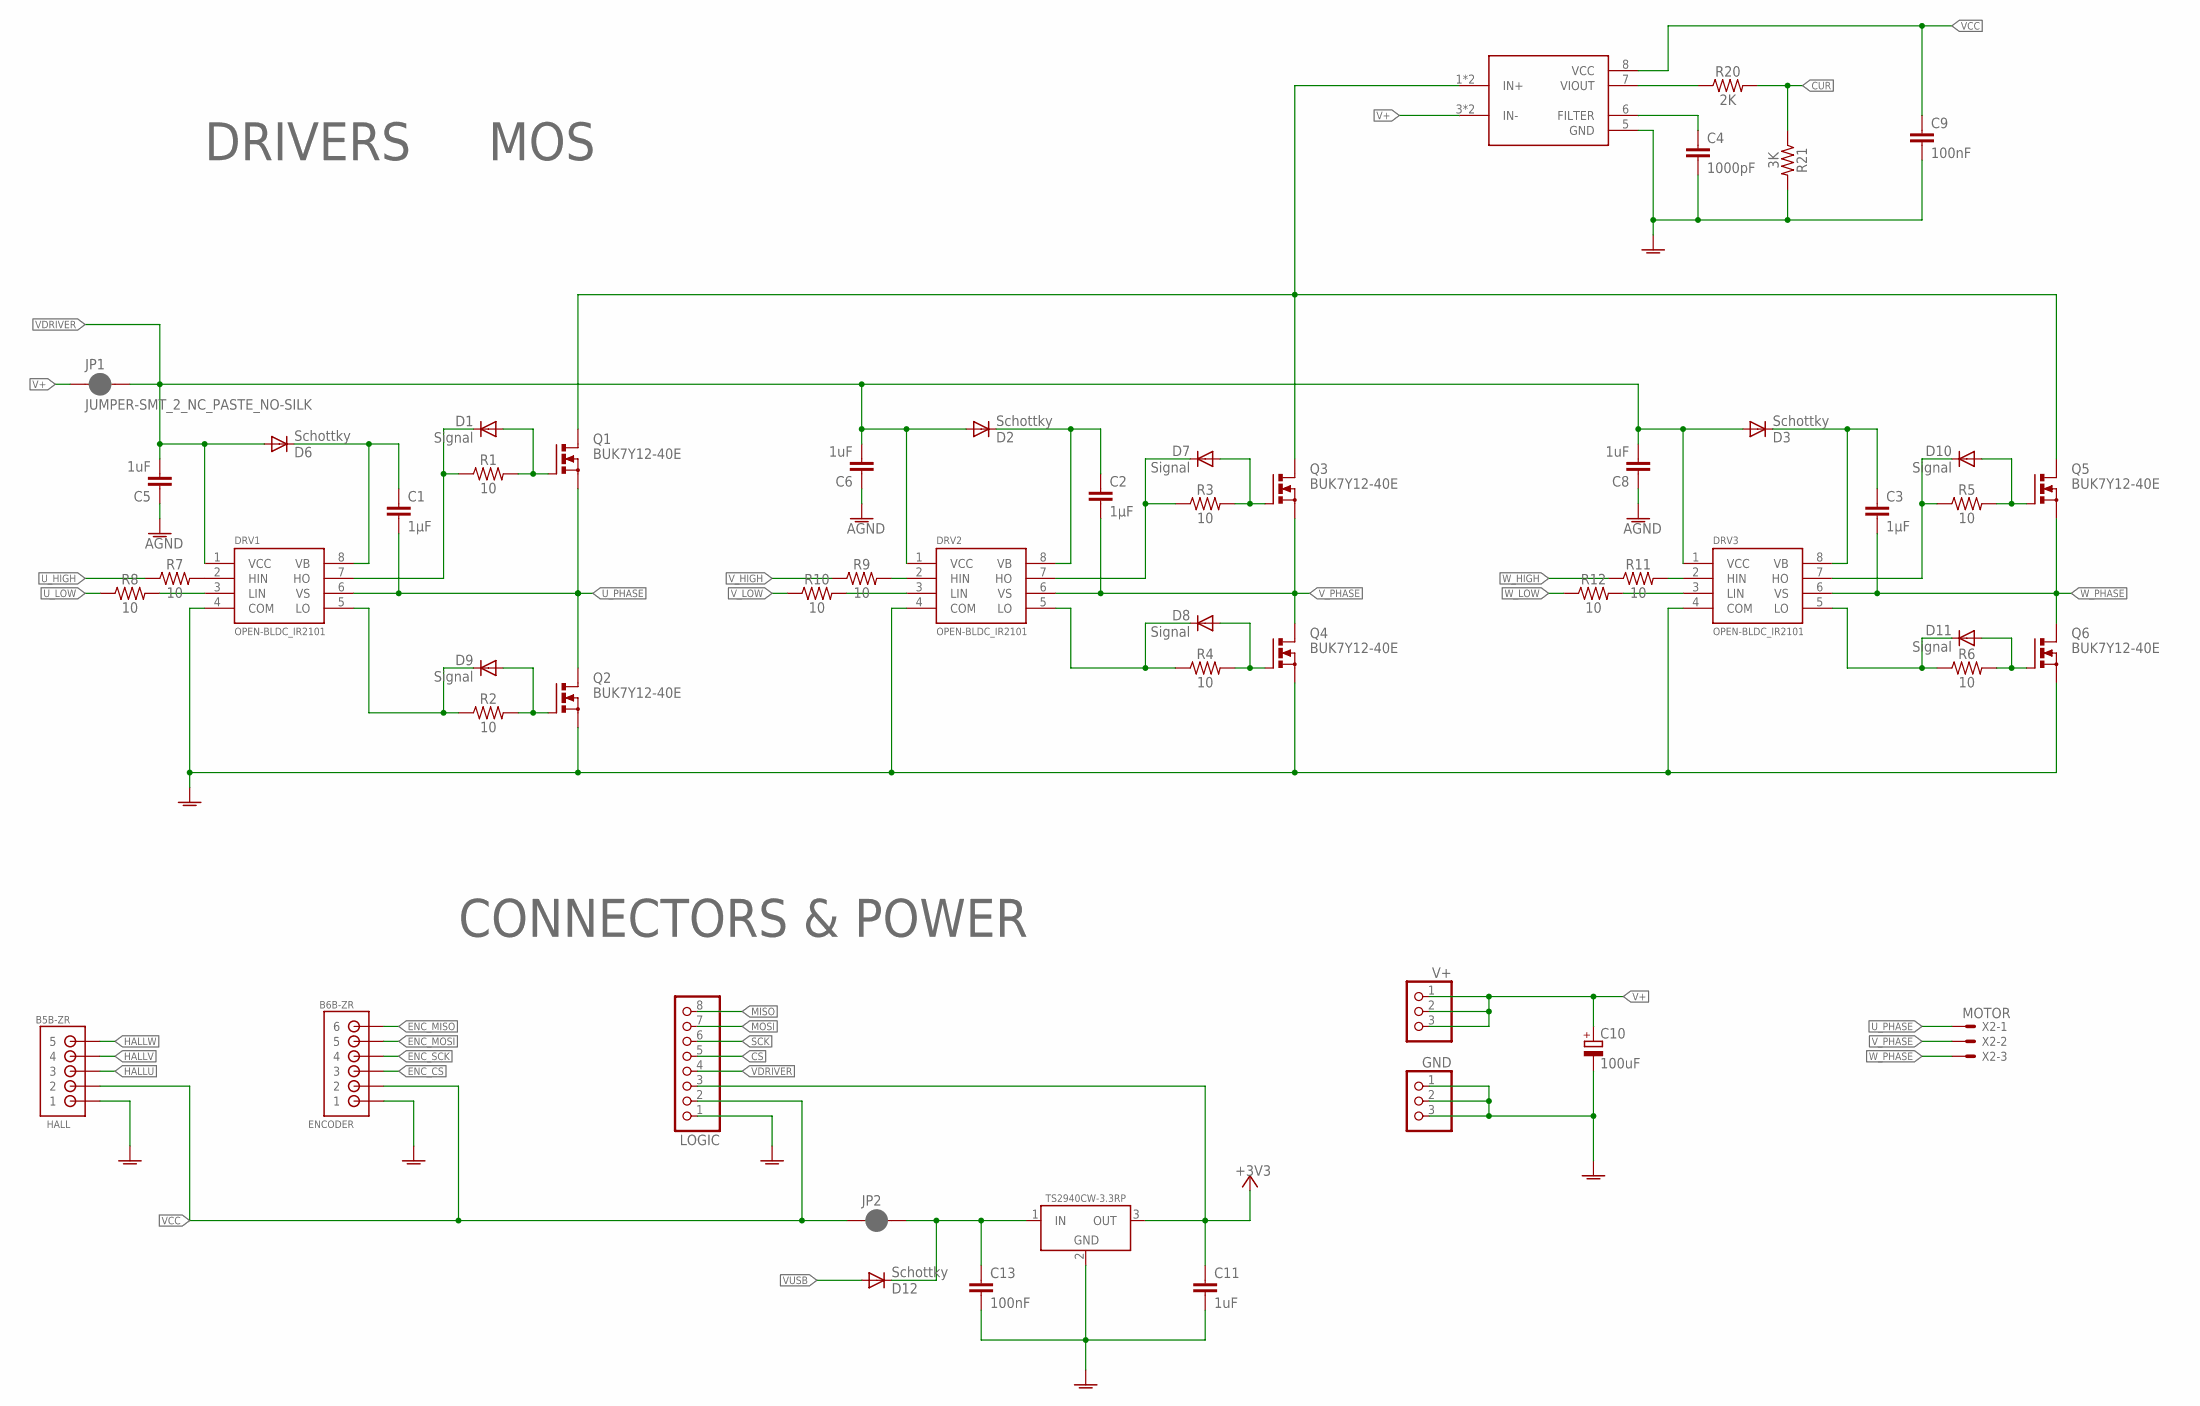
[picture p125: schematic brushless.sch, sheet 2]

Parts:
C1, C2, C3: 1µF; 0805; FARNELL 2528772
C4: 1000pF; 0805@1; FARNELL 2496935
C5, C6, C8: 1uF; 0805@1; FARNELL 2496946
C9, C13: 100nF; 0805@1; FARNELL 2496935
C10: 100uF; E3,5-8; FARNELL 1870964
C11: 1uF; 0805@1; FARNELL 2496935
D1, D7, D8, D9, D10, D11: Signal; SOD-323; FARNELL 1843678RL
D2, D3, D6, D12: Schottky; SOD-323; FARNELL 2760406
DRV1, DRV2, DRV3: OPEN-BLDC_IR2101; OPEN-BLDC_SO-8; FARNELL 8638730
ENCODER: B6B-ZR
GND: CONNEC_1X03; FARNELL 1022248
HALL: B5B-ZR
JP1, JP2: JUMPER-SMT_2_NC_PASTE_NO-SILK; SMT-JUMPER_2_NC_PASTE_NO-SILK
LOGIC: CONNEC_1X08; FARNELL 1022256
Q1, Q2, Q3, Q4, Q5, Q6: BUK7Y12-40E; SOT669; FARNELL 2319916
R1, R2, R3, R4, R5, R6, R7, R8, R9, R10, R11, R12: 10; 0805; FARNELL 2446904
R20: 2K; 0805; FARNELL 2446939
R21: 3K; 0805; FARNELL 2446965
REG1: TS2940CW-3.3RP; SOT223; FARNELL 7261403
SENSE: ACS712; SO8; FARNELL 1329624
V+: CONNEC_1X03; FARNELL 1022248
X2: MOTOR; JST-XH-03-PACKAGE-LONG-PAD

Connections:
+3V3: C11.1, LOGIC.3, REG1.3 (OUT); also elsewhere on the board
AGND: C4.2, C5.1, C6.1, C8.1, C9.2, C10.-, C11.2, C13.2, DRV1.4 (COM), DRV2.4 (COM), DRV3.4 (COM), ENCODER.1, GND.1, GND.2, GND.3, HALL.1, LOGIC.1, Q2.1 (S), Q2.2 (S), Q2.3 (S), Q4.1 (S), Q4.2 (S), Q4.3 (S), Q6.1 (S), Q6.2 (S), Q6.3 (S), R21.2, REG1.2 (GND), SENSE.5 (GND); also elsewhere on the board
CS: LOGIC.5; also elsewhere on the board
CUR: R20.2, R21.1; also elsewhere on the board
ENC_CS: ENCODER.3; also elsewhere on the board
ENC_MISO: ENCODER.6; also elsewhere on the board
ENC_MOSI: ENCODER.5; also elsewhere on the board
ENC_SCK: ENCODER.4; also elsewhere on the board
HALLU: HALL.3; also elsewhere on the board
HALLV: HALL.4; also elsewhere on the board
HALLW: HALL.5; also elsewhere on the board
MISO: LOGIC.8; also elsewhere on the board
MOSI: LOGIC.7; also elsewhere on the board
unnamed: D7.2 (A), Q3.4 (G), R3.2
unnamed: D9.2 (A), Q2.4 (G), R2.2
unnamed: DRV1.2 (HIN), R7.2
unnamed: C1.1, D6.1 (C), DRV1.8 (VB)
unnamed: D8.2 (A), Q4.4 (G), R4.2
unnamed: D10.2 (A), Q5.4 (G), R5.2
unnamed: DRV1.3 (LIN), R8.2
unnamed: D11.2 (A), Q6.4 (G), R6.2
unnamed: C2.1, D2.1 (C), DRV2.8 (VB)
unnamed: D1.2 (A), Q1.4 (G), R1.2
unnamed: D10.1 (C), DRV3.7 (HO), R5.1
unnamed: D11.1 (C), DRV3.5 (LO), R6.1
unnamed: DRV2.3 (LIN), R10.2
unnamed: C3.1, D3.1 (C), DRV3.8 (VB)
unnamed: DRV2.2 (HIN), R9.2
unnamed: DRV3.2 (HIN), R11.2
unnamed: DRV3.3 (LIN), R12.2
unnamed: C13.1, D12.1 (C), JP2.2, REG1.1 (IN)
unnamed: R20.1, SENSE.7 (VIOUT)
unnamed: C4.1, SENSE.6 (FILTER)
SCK: LOGIC.6; also elsewhere on the board
U_GATE_HIGH: D1.1 (C), DRV1.7 (HO), R1.1
U_GATE_LOW: D9.1 (C), DRV1.5 (LO), R2.1
U_HIGH: R7.1; also elsewhere on the board
U_LOW: R8.1; also elsewhere on the board
U_PHASE: C1.2, DRV1.6 (VS), Q1.1 (S), Q1.2 (S), Q1.3 (S), Q2.MB (D), X2.1
V+: C10.+, JP1.1, SENSE.3 (IN-), SENSE.4 (IN-), V+.1, V+.2, V+.3
V+_MOS: Q1.MB (D), Q3.MB (D), Q5.MB (D), SENSE.1 (IN+), SENSE.2 (IN+)
VCC: C9.1, ENCODER.2, HALL.2, JP2.1, LOGIC.2, SENSE.8 (VCC); also elsewhere on the board
VDRIVER: C5.2, C6.2, C8.2, D2.2 (A), D3.2 (A), D6.2 (A), DRV1.1 (VCC), DRV2.1 (VCC), DRV3.1 (VCC), JP1.2, LOGIC.4
VUSB: D12.2 (A); also elsewhere on the board
V_GATE_HIGH: D7.1 (C), DRV2.7 (HO), R3.1
V_GATE_LOW: D8.1 (C), DRV2.5 (LO), R4.1
V_HIGH: R9.1; also elsewhere on the board
V_LOW: R10.1; also elsewhere on the board
V_PHASE: C2.2, DRV2.6 (VS), Q3.1 (S), Q3.2 (S), Q3.3 (S), Q4.MB (D), X2.2
W_HIGH: R11.1; also elsewhere on the board
W_LOW: R12.1; also elsewhere on the board
W_PHASE: C3.2, DRV3.6 (VS), Q5.1 (S), Q5.2 (S), Q5.3 (S), Q6.MB (D), X2.3

Notes on the sheet:
MOS
DRIVERS
CONNECTORS & POWER

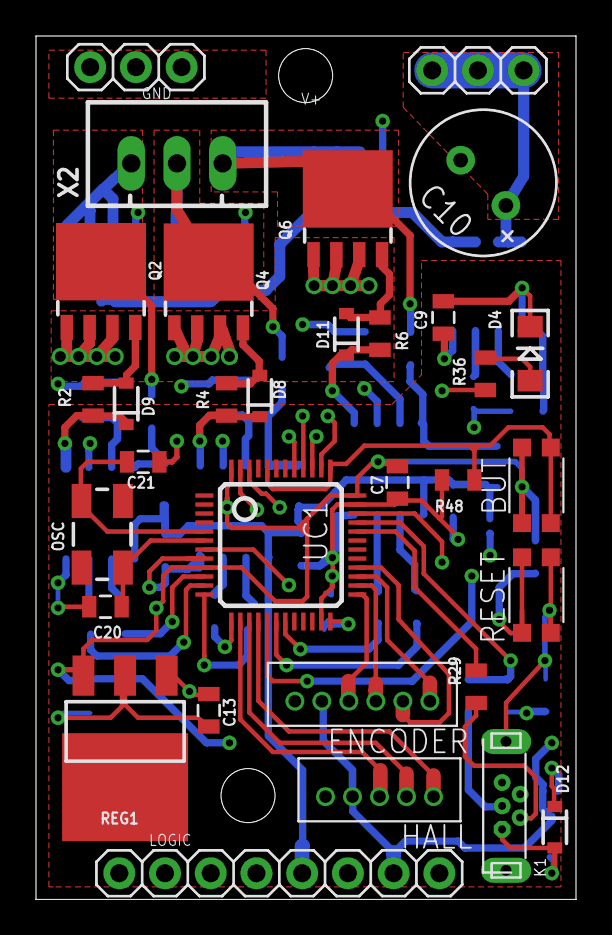
[picture p126: board brushless.brd from above]

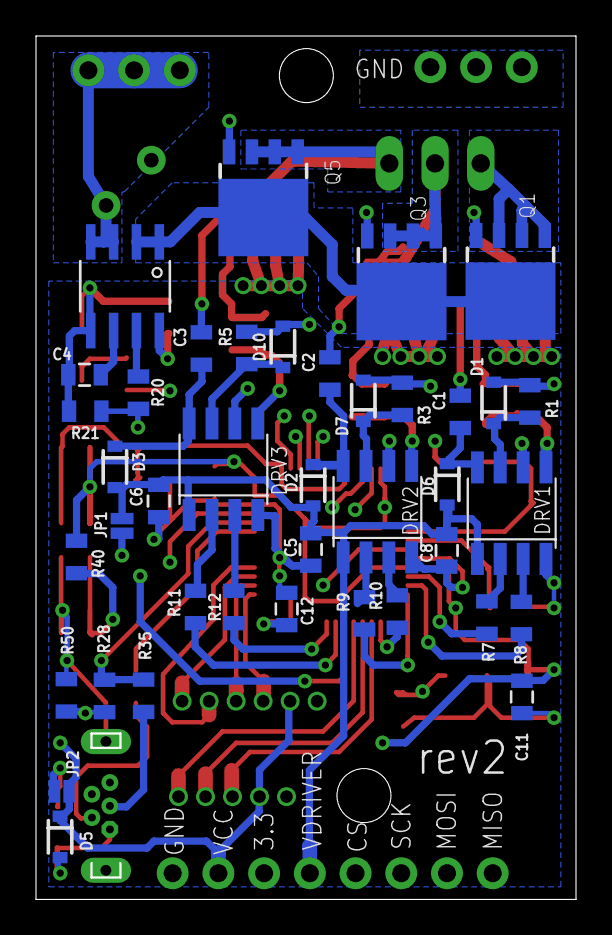
[picture p127: board brushless.brd from below]

Board: 4 copper layers, 30.0 x 48.0 mm, 72 parts (40 on the bottom side), 63 nets.
